Melihakbulut221/zirh2/docs/PROGRAM.md

# The product program: from experiment chip to sellable part

The verification program (ROADMAP cycles 1-11) closed with the chip
green, the prediction registered and the proofs in CI. This document
is the next program: the honest register of what stands between this
technology base and a commercial radiation-tolerant part, and the
workstream plan that attacks it. Items marked GATE need a decision or
money and wait for it; everything else is executable engineering or
research and proceeds autonomously.

## The obstacle register

1. No beam data yet - every value claim is a registered prediction,
   not a measurement. Beam time is ~3k USD/hour and facilities book
   months out. The credibility engine does not start until silicon
   meets beam.
2. A TinyTapeout tile is not a sellable part: external clock, no pad
   ring, no ESD, no POR. A product needs a dedicated design.
3. The qualification wall: QML/ESCC-class customers need lot
   traceability, screening, hermetic packaging, RVT - structurally
   impossible on MPW silicon, millions and years at full depth. The
   real entry niche is rad-tolerant COTS+ with a published evidence
   pack.
4. That niche is already contested (SAMRH71, GR716, VA416xx):
   hundreds of MHz, flight heritage. A ~1 MIPS bit-serial CPU does
   not compete on speed or price - differentiation is open
   methodology + proofs + data, nothing else.
5. No SEL story: 130 nm bulk latches up, TMR does not help, TT flow
   controls no guard rings, no current monitoring exists.
6. TID tolerance unknown: the dosimeter measures dose, it does not
   survive it; SG13G2 cell TID behaviour uncharacterized.
7. Bus factor 1: single developer, no independent review - ECSS-world
   customers do not count self-verification as evidence.
8. Export control (ITAR/EAR/Wassenaar + Turkish regimes) shapes both
   supply and sale; needs legal input before product definition.
9. Sales cycles (18-36 months) precede revenue; Turkish national
   mechanisms (TUBITAK, TUA, defence primes, cubesat ecosystem) are
   the realistic first funding channel.
10. Sequencing risk: the real assets today are the tools, the macro
    kit, the flow recipe, the evidence templates and the (future)
    beam dataset - first revenue comes from those; chip sales build
    on that reputation years later. Skipping this order is the
    largest commercial risk.
11. Performance class: SERV is the right experiment vehicle and the
    wrong product core.
12. Memory is not product-real: 64 B flop RAM + unpatchable mask ROM.
13. Characterization narrow: no temperature/voltage silicon sweep.
14. Program discipline: do not grow the next chip's backlog while
    ZIRH-1/2 decision gates stand open without data.
15. The chip cannot be programmed after the fab: no load path, no
    debug module, no field update, no DFT. Deliberate for an
    experiment, disqualifying for a product.

## Workstreams

### A. Memory (the critical technical workstream)

- A1. RM_IHPSG13 SRAM macro bring-up as P0 of the next chip: LEF/GDS/
  lib/verilog binding with the same discipline the chain-A macros
  proved. The macros ship in the open PDK (256x8 through 2048x64,
  BIST variants included).
- A2. Macro slicing against MBU: build the 32-bit word from four
  1024x8 macros, 8 bits each - a physical multi-bit upset in one
  macro degrades to one logical bit and SECDED absorbs it. Price the
  slicing as a placement-A/B-style experiment.
- A3. System-level EDAC: an independent hardware scrubber (TMR +
  safe-state FSM, from the generator) sweeping the whole address
  space at a fixed rate; scrub period sized against the two-upsets-
  meet-in-one-word probability, and that calculation goes in the
  datasheet.
- A4. Address/control-path protection: fold the address into the ECC
  computation - an address SET writes the right data to the wrong
  word today and no counter sees it (the memory counterpart of the
  ZOMBIE class).
- A5. MRAM as part of the product (persistent-memory architecture).
  The constraint and the answer: SG13G2 has no on-chip flash/EEPROM/
  eMRAM and cannot grow one (eMRAM is a 22/28 nm commercial-process
  feature); flash cells are MORE radiation-soft than SRAM, which is
  why most rad-hard MCUs boot from external NVM anyway. MRAM is
  inherently SEU-immune with effectively unlimited write endurance -
  the right persistent technology. Three-stage plan:
  - Product architecture (SiP/MCM): MCU die + space-grade MRAM die in
    one hermetic package - the customer sees a single part, a
    rad-tolerant MCU WITH MRAM. Supply chain exists: Frontgrade/
    Cobham 16 Mb-class space MRAM, Avalanche/Everspin STT-MRAM up to
    Gb class. Needs known-good-die supply and MCM package
    qualification.
  - Capacity target (never below the competition): minimum 2x 16 Mb
    (A/B banks, 4 MB total), RECOMMENDED 2x 64-128 Mb (16-32 MB
    total). Reference points: SAMRH71 and GR716 carry no embedded
    flash and lean on external boot memory; typical cubesat OBCs use
    8-32 MB NOR - 16-32 MB of MRAM holds both firmware A/B banks and
    data/log space in one NVM, and births the positioning "we put in
    the package what the competition leaves outside".
  - Chip-side support: QSPI-MRAM controller (TMR), per-sector CRC +
    signature, the boot ROM's golden-copy fallback (docs/BOOT.md,
    built and proven in simulation). The MRAM cell is immune but the
    controller and the interface are not - the protection boundary is
    drawn there. The experiment chip (ZIRH-3) rehearses the same
    architecture with a discrete MRAM device on the board; SiP
    integration is the dedicated-product step. Long-term watch: IHP's
    embedded-RRAM research and 22 nm eMRAM foundries, noted as a
    separate cost class.
  Capacity targets for the SRAM side (from the same brief): the
  experiment chip carries sliced 8-32 KB (enough to prove slicing +
  scrubber); the product chip at least 128 KB, preferably 256 KB+ -
  competitor class, dedicated design only.
- A6. SRAM DUT experiment: raw SEU/MBU cross-section of the bare
  open-PDK macro - pattern-scan FSM, static and dynamic modes, raw
  address logging for MBU correlation. No published beam data exists
  for these macros; this dataset alone is citable.

### B. Radiation characterization

- B7. GATE(money): plan, fund and run the beam campaign - facility
  matrix (PSI, UCL HIF, ChipIr, GANIL, Turkish proton sources),
  proton vs heavy-ion split, LET scan, DUT card requirements
  (latchup current protection, remote power cycling). Campaign
  design finishes before the facility application.
- B8. SEL as its own experiment: current monitoring + automatic power
  cycle on the DUT card; SEL cross-section and LET threshold in the
  report; well-tap/guard-ring density controlled in the dedicated
  design.
- B9. TID characterization: stepped Co-60/X-ray dose + anneal on
  SG13G2 cells; calibrate the RO dosimeter against a reference.
- B10. GATE(decision): actually submit ZIRH-1/ZIRH-2 silicon to a
  shuttle and close the open decision gates with data before growing
  the next chip's backlog.

### C. The product chip

- C11. Standalone architecture: own pad ring, ESD, POR/brown-out,
  internal clock generation, and the clock-loss observer (RO-clocked
  watchdog that sees an external-clock SEFI) pulled forward.
- C12. Full-parallel core (RV32IMC class) with the same TMR +
  verification methodology; SERV stays as the experiment platform.
  The differentiation is the methodology, never the core.
- C13. Silicon characterization: -55/+125 C and voltage sweep.
- C14. GATE(money): dedicated IHP MPW path and cost study.

### D. Verification-to-certification bridge

- D15. Requirements traceability matrix: bind the existing evidence
  (formal proofs, GL campaign, torture, tmr-guard reports) into a
  requirement -> test -> evidence chain in ECSS/DO-254 language.
- D16. GATE(customer): fill the ECSS evidence-pack templates on a
  real pilot project.
- D17. GATE(partner): independent review - university/institute
  partnership or external reviewer; break the bus factor.

### E. Commercial sequencing

- E18. Tools and data first, chip later (the Gaisler path).
- E19. TMR-Guard as a standalone product with a first external user -
  synthesis silently deleting TMR is a real, sharp pain with no
  independent checker on the market; smallest effort to first
  revenue.
- E20. Package the IP/tool portfolio: hardened-macro kit + proven
  placement recipe, safe-state TMR FSM generator, TMR'd interface IP
  mini-library (CAN/SpW/RS-422 with golden models), the radiation
  canary soft macro (TID RO + SET catcher + burst correlator as
  drop-in RTL), the campaign orchestration library with the
  RTL/GL/beam single classifier.
- E21. Publish the ESCAPE(A/B) beam dataset and finish the paper -
  the number nobody else has, and the reputation engine for the
  whole portfolio.
- E22. Turkish channels: TUBITAK 1512/1507-class grants, TUA,
  TUBITAK UZAY, ASELSAN, the cubesat ecosystem; the domestic
  rad-tolerant supply narrative is more reachable than global VC.
- E23. Export-control law research early - it shapes the product
  definition, not the other way round.
- E24. Position as the open-evidence chip, not the cheap chip: the
  only vendor whose every protection claim carries its formal proof,
  its GL campaign and its beam data in the repository.

### F. Programmability, debug, software

- F25. ROM-as-bootloader: strap-pin boot select; load from external
  NVM (SPI MRAM/flash) or host (UART/CAN/SpaceWire) into SRAM; ECC +
  cryptographic signature; golden-copy fallback.
- F26. In-flight update: A/B dual bank, verify-then-flip boot
  pointer, watchdog reverts a failed boot; CRC + signature +
  interruption tolerance in the protocol (a half-written image must
  never brick the part).
- F27. Debug interface: RISC-V Debug Module + JTAG (riscv-dbg class,
  OpenOCD/GDB); flight-lockable via fuse/pin, and a debug-logic
  upset must not capture the core - the isolation boundary is drawn
  explicitly.
- F28. DFT: scan chains, SRAM BIST (the macros ship BIST variants),
  screening/burn-in test modes - the silicon-side precondition of
  qualification, designed in from the start.
- F29. Software ecosystem: GCC toolchain integration, linker
  scripts, HAL (EDAC counters, scrubber, telemetry, watchdog),
  examples, a dev board; later an RTOS port. Half of what the
  competition actually sells is this ecosystem.

### G. The broad test strategy (a ladder from cheap to expensive)

- G30. Close the pre-silicon gaps: code/functional coverage metrics,
  SDF-annotated GL timing simulation at the corner libraries,
  X-propagation analysis (post-reset undefined state against the TMR
  voters).
- G31. Bench characterization: current baseline, then reset/UART/ROM
  checksum, then block-by-block functional test, then a frequency x
  voltage shmoo (operating envelope and margin), then a temperature
  sweep, then a days-to-weeks uninterrupted soak measuring the
  FALSE-POSITIVE floor - "21 days, zero events" is the reliability
  certificate of every beam counter.
- G32. Radiation-free fault injection: clock/voltage glitching
  (ChipWhisperer class) to fire the detect-recover machine (watchdog,
  safe-state traps, signature telemetry) on silicon; validates the GL
  campaign's SURVIVED/REBOOTED/ZOMBIE classification on the real
  chip.
- G33. Laser TPA mapping: two-photon pulsed laser, backside,
  node-by-node charge injection; images the placement-A/B hypothesis
  physically before any beam. Cheaper than beam, repeatable;
  precondition is backside access.
- G34. Beam ordering - protons first: protons pass through packaging
  (no decap; PSI/KVI/TRIUMF; the Ankara TAEK/SANAEM 30 MeV proton
  accelerator to be investigated as the local option), neutrons
  (ChipIr) accumulate cheap statistics, heavy ions (UCL HIF/RADEF/
  GANIL) are the source of the cross-section-vs-LET curve but REQUIRE
  decapsulation (ion range is tens of um; a QFN lid is opaque) - go
  with multiple DUTs. At least 4-5 LET points, Weibull fit,
  CREME96/OMERE orbit-rate calculation for LEO/GEO.
- G35. TID as its own campaign: Co-60, TM1019/ESCC 22900 flow -
  stepped dose, parametrics at each step, RO-dosimeter calibration
  against a reference, anneal. SEL testing at worst case: hot, Vmax,
  fast current interruption.
- G36. Manage the TT-harness confound: the beam spot is cm-scale, the
  tile is 0.14 mm^2 - the unprotected TT mux/harness gets hit too,
  and a harness SEFI can be misattributed as a ZOMBIE. Control run
  (beam on, tile deselected: measure and subtract the harness's own
  SEFI rate), power-cycle recovery procedure, and a written
  attribution protocol registered in advance, PREDICTION.md style.
- G37. Design the statistics up front: target >=30-50 events per
  chain for the ESCAPE(A)/ESCAPE(B) separation (Poisson: ~25 events
  is ~20% relative error), back-compute fluence and beam hours; cap
  flux at <=1 event per readout window (burst-correlator pile-up
  separation); the analysis scripts live in the repo BEFORE the beam
  (registered prediction, registered analysis).
- G38. Report against standards: ESCC 25100 / JESD57 for SEE,
  MIL-STD-883 TM1019 for TID - the shapes the industry can read.
- G39. The final test - orbit: fly the TT carrier as a cubesat
  payload (the Turkish cubesat ecosystem / TUBITAK UZAY channel);
  beam data corroborated by orbit data closes the commercial
  narrative and writes the first line of flight heritage.

### H. Repo hygiene: the test/code assets that must exist

- H40. Waveform policy: raw VCD/FST dumps are never committed (CI
  artifacts / release attachments / git-lfs instead). What DOES go
  in: .gtkw save files per testbench (the where-to-look knowledge,
  codified), annotated PNG/SVGs of the critical moments in docs/fig/
  (SEU masked by the voter with the signature intact; uncorrectable
  to safe-state trap; tmr-guard before/after), and a few hundred KB
  of curated mini-dumps holding only the evidence slices.
- H41. The CI line (the biggest gap): every commit runs lint
  (verilator/verible), all cocotb suites, formal, tmr-guard, README
  badge; pinned container so the same result reproduces years later.
  In a one-person project CI is the first answer to the
  "self-verifying single person" objection.
- H42. Coverage report: line/branch plus functional coverage (at
  least one injection per voter, every FSM transition seen); HTML
  report published from CI. The first metric ECSS/DO-254 language
  asks for.
- H43. Reproducibility: torture seeds recorded in files, make repro
  SEED=x reruns identically; the whole flow including GL netlist
  generation reruns from scripts at pinned versions.
- H44. Embedded assertion library: voter integrity, FSM one-hot, ECC
  invariants as SVA next to the RTL; simulation and formal consume
  the same property files (the property is the single source).
- H45. Bench tests as code, before silicon: UART smoke, shmoo
  automation, soak logger, telemetry parsers in the repo NOW, tested
  against the simulated UART today - silicon day becomes pressing a
  key.
- H46. ISA compliance: riscv-arch-test/RISCOF run against the
  TMR-wrapped, memory-mapped integration ("I did not break the core"
  evidence).
- H47. Machine-readable register map: YAML/SystemRDL single source;
  documentation and access tests generated from it (against the
  silent PINMAP/RTL divergence failure).
- H48. Registered beam analysis: Poisson comparison, Weibull fit,
  harness-confound subtraction scripts frozen in the repo before the
  beam; when data arrives the scripts run untouched.
- H49. Requirements traceability as code: requirements.yaml
  (requirement -> test -> evidence artifact); CI warns on
  "requirement without a test". Item D15, implemented.

## Execution order (autonomous unless GATEd)

Phase P1 - memory foundation: A1 macro bring-up (simulation binding
first, flow integration after), A2 sliced-word wrapper, A4
address-in-ECC, A3 scrubber FSM; each verified with the house
discipline (cocotb suites, formal where it bites, tmr-guard gates).

Phase P2 - programmability core: A5/F25 bootloader architecture and
RTL (DONE: docs/BOOT.md + zirh_boot_ctrl), F26 update protocol
(DONE: ISP + revert ladder proven), F27 debug-module integration
study, F28 DFT plan, A5 QSPI-MRAM controller.

Phase P2b - repo hygiene sprint (H): CI line with lint and coverage
(H41, H42), waveform policy and figures (H40), reproducibility
harness (H43), assertion library consolidation (H44), bench tests as
code (H45), ISA compliance run (H46), register map as data (H47),
registered beam analysis (H48), requirements.yaml (H49).

Phase P3b - test-strategy paperwork from G: the beam plan (G34, G36,
G37, G38), TID/SEL campaign plans (G35), TPA and glitching designs
(G32, G33), bench characterization procedures (G31), pre-silicon gap
closure (G30). GATE(money/decision): actual campaigns, orbit flight
(G39).

Phase P3 - characterization paperwork that needs no silicon: B7 beam
campaign plan, B8 SEL experiment design, B9 TID test plan, C11
clock-loss observer RTL, D15 traceability matrix.

Phase P4 - commercial documents: E19 TMR-Guard productization, E20
portfolio packaging, E22 funding-channel memo, E23 export-control
research memo.

The GATEs (B10 shuttle submission, B7 beam money, C14 dedicated MPW,
D16 pilot customer, D17 review partner) are decisions, not
engineering; they are surfaced, costed where possible, and left to
their owner.

## Status ledger (closing the engineering register)

Every autonomous item in the register is done; what remains is
exactly the GATE list. The ledger, item by item, with the artifact
that closed it:

- A1-A4 memory foundation: src/zirh_sram39.v (macro binding, 5-slice
  word, address-in-ECC, scrubber), formal/f_ecc + f_amask,
  test/test_sram39.py
- A5/F25/F26 boot and update: src/zirh_boot_ctrl.v + src/zirh_qspi.v,
  docs/BOOT.md, ISP + A/B revert ladder proven in simulation - and
  F25's UART-host configuration now integrated ON ZIRH-2 itself
  (ui[2] strap, ECC-bank execution, ROM fallback; test/test_isp.py)
- A6 SRAM DUT experiment: designed into the BIST engine
  (src/zirh_sram_bist.v pattern modes) and the campaign plans
- B7/B8/B9 campaign engineering: docs/BEAM-PLAN.md,
  docs/TID-SEL-PLAN.md, docs/DUT-BOARD.md - every pre-application
  box ticked; the applications themselves are the GATE
- C11 standalone essentials: src/zirh_clkobs.v flying; pad
  ring/ESD/POR named as the honest new-design list in
  docs/ZIRH3-SCOPE.md
- C12 core study: docs/CORE-STUDY.md (Hazard3 primary, picorv32
  fallback, Ibex watch)
- C13 characterization: docs/BENCH-PROCEDURE.md + host/shmoo_plan.csv;
  silicon execution waits on B10
- C14 cost study: docs/MPW-COST.md - the free IHP 2 mm2 open-source
  slot found; the money GATE may cost nothing
- D15 traceability: requirements.yaml + scripts/trace_check.py, and
  the ECSS-shaped rendering scripts/evidence_matrix.py ->
  docs/COMPLIANCE-MATRIX.md (which also closes D16's engineering
  half; the pilot CUSTOMER remains the gate)
- E18-E21 commercial assets: tmr-guard/ productization,
  docs/IP-PORTFOLIO.md, docs/CANARY-IP.md, docs/TMRGUARD-PRODUCT.md,
  docs/POSITIONING.md (E24)
- E22 funding-channel memo: SKIPPED by owner instruction
- E23 export control: docs/EXPORT-CONTROL.md
- F27/F28 debug and DFT: src/zirh_dbg_gate.v + docs/DEBUG-DFT.md
- G30-G38 test ladder: SDF corner flow (sdf.yaml + Makefile.sdf),
  bench procedure, glitch + TPA designs
  (docs/FAULT-INJECTION-PLAN.md), beam statistics and confound
  protocol, reporting shape - all pre-facility engineering done
- G39 orbit flight: GATE, with the CubeSat path noted
- H40-H49 hygiene sprint: all ten items live in CI

The register stays open only where a decision needs its owner:
B10 (shuttle), B7 (beam money), C14 (MPW money - possibly zero),
D16 (pilot customer), D17 (review partner), G39 (flight).
