Melihakbulut221/zirh2/docs/COMPLIANCE-MATRIX.md

# ZIRH-2 compliance matrix (ECSS-shaped pilot)

GENERATED by scripts/evidence_matrix.py from requirements.yaml - the D16 pilot: the evidence-pack shape filled from a real project's requirements, every row citing an artifact that runs in CI today. Verification method is inferred from where each requirement's evidence lives. Regenerated and diffed in CI, so the matrix cannot drift from the requirements the build already gates.

**29 requirements** across 7 verification-method classes:

- Test: 12
- Formal Proof + Test: 5
- Analysis/Tool: 3
- Test + Analysis/Tool: 3
- Analysis/Tool + Review/Inspection: 2
- Review/Inspection: 2
- Test + Review/Inspection: 2

| ID | Requirement | Method | Verification artifacts | Evidence location |
|---|---|---|---|---|
| R1 | A single upset in any one TMR replica shall never reach a voted output, in any cycle, at silicon timings. | Formal Proof + Test | `formal/f_ring.sv`<br>`test/test_gl_seu_sweep.py` | formal.yaml formal job (BMC + k-induction, N=4/8/32); gds.yaml gl_test (384 exhaustive singles on the shipped netlist) |
| R2 | An escape shall require the same bit upset in two replicas within one clock cycle, and no other fault geome... | Formal Proof + Test | `formal/f_ring.sv`<br>`test/test_gl_seu_sweep.py` | formal cover witness (docs/fig/escape_witness.png); pair geometry sweep in gl_test; registered in docs/PREDICTION.md |
| R3 | The SECDED memory shall correct every single stored-bit error at all 39 positions, detect every double, and... | Formal Proof + Test | `formal/f_ecc.sv`<br>`test/test_sram39.py` | formal.yaml (exhaustive BMC over words, faults, initial states); ci.yaml units job on the macro-backed storage |
| R4 | A wrong-row read - any single-bit address corruption at the memory boundary - shall decode as uncorrectable... | Formal Proof + Test | `formal/f_amask.sv`<br>`test/test_sram39.py` | formal.yaml (all words x all fold-distinct row pairs); wrong-row detection case in the sram39 suite |
| R5 | The background scrubber shall repair a corrupted word no firmware access ever touches, within one sweep per... | Test | `test/test_sram39.py` | ci.yaml units job (scrubber heal case; micro-interleave behaviour proven during the Cycle-12 ghost hunt) |
| R6 | An interrupted or corrupted firmware load shall never produce a bootable-looking bank; the no-brick propert... | Test | `test/test_boot.py` | ci.yaml units job (half-load and bad-CRC cases; valid flag flips only on stored-image read-back CRC) |
| R7 | A firmware that fails to sign on shall be reverted automatically - other valid bank first, golden ROM last ... | Test | `test/test_boot.py` | ci.yaml units job (watchdog revert ladder case) |
| R8 | The debug domain shall be lockable for flight such that no debug-side activity or upset reaches the core or... | Formal Proof + Test | `formal/f_dbg.sv`<br>`test/test_dbg_gate.py` | formal.yaml (inertness + absorbing-verdict induction); ci.yaml units job (hammering, strap-wiggle, passthrough) |
| R9 | The SRAM march self-test shall detect a disturbed cell at its exact address and slice, and the beam scan mo... | Test | `test/test_bist.py` | ci.yaml units job (march clean, disturb-detect-preserve, rescreen clean) |
| R10 | Every TMR structure shall survive synthesis with its replicas and voters intact; collapse shall fail the bu... | Analysis/Tool | `scripts/check_tmr.sh`<br>`tmr-guard/tmr_guard.py` | ci.yaml tmr-guard job (replica and flop counts pinned in both directions; the product tool runs its flagship manifest... |
| R11 | The computer's liveness and death shall be separable from the instrument's at the pins, and a computer deat... | Test | `test/test.py`<br>`test/test_gl_campaign.py` | test.yaml (frame/signature/watchdog cases); gds.yaml gl_test campaign contract (SURVIVED/REBOOTED/ZOMBIE, silence for... |
| R12 | The processor integration - pipelined fetch, ROM data port, bus, ECC RAM - shall execute random RV32I progr... | Test + Analysis/Tool | `scripts/torture_gen.py`<br>`scripts/torture.sh`<br>`test/test_torture.py` | formal.yaml torture job (30 programs, daily seed, seed printed for replay; 100/100 on the recorded seeds) |
| R13 | The ZIRH-authored RTL shall lint clean under the armed warning set; waivers shall be few and individually j... | Analysis/Tool | `scripts/lint.sh` | ci.yaml lint job |
| R14 | The pre-beam prediction and its analysis shall be frozen in the repository before any beam exposure; beam d... | Analysis/Tool | `scripts/seu_predict.py` | docs/PREDICTION.md (git history is the registration timestamp); G48 registered-analysis scripts are the successor ite... |
| R15 | Every interface experiment - CAN, SpaceWire, RS-422 framing and the CPU-untouchable telemetry mirror - shal... | Test | `test/test_can.py`<br>`test/test_spw.py`<br>`test/test_rs422.py`<br>`test/test_mirror.py`<br>`test/test_uart_regs.py` | test.yaml unit runs (protocol FSMs, loopback, flood atomicity) |
| R16 | The TMR register library shall heal any single-replica flip through voted feedback and report the mismatch,... | Test | `test/test_tmr.py`<br>`test/test_tmrflip.py` | test.yaml unit runs (per-width flip sweeps, err pulse checks) |
| R17 | Under sustained random stress - command fuzzing, flip storms, marathon soak, reboot storms - the chip shall... | Test | `test/test_fuzz.py`<br>`test/test_storm.py`<br>`test/test_mega.py`<br>`test/test_campaign.py` | test.yaml marathon runs; host/zirh_campaign.py contract; 30-trial x 2-seed campaign records in docs/SCOPE.md |
| R18 | Every block shall hold its unit contract in isolation - reset and clocking, bus slave protocol, ECC RAM sem... | Test | `test/test_clk_rst.py`<br>`test/test_bus.py`<br>`test/test_ecc_ram.py`<br>`test/test_env.py`<br>`test/test_hk.py`<br>`test/test_rom.py`<br>`test/test_soc.py`<br>`test/test_tlm2.py`<br>`test/test_z2.py` | test.yaml and ci.yaml unit runs |
| R19 | The open-PDK SRAM macro behavioral model shall be bound and exercised - write, synchronous read, bit-mask m... | Test | `test/test_sram_smoke.py` | ci.yaml units job (bare macro smoke) |
| R20 | The register map shall have one machine-readable source; documentation and firmware headers shall be genera... | Analysis/Tool + Review/Inspection | `regmap.yaml`<br>`scripts/regmap_gen.py` | ci.yaml trace job (regmap sync gate + fw/zirh.h address cross-check) |
| R21 | The bench bring-up ladder - smoke, soak with a measured false-positive floor, shmoo envelope mapping - shal... | Analysis/Tool + Review/Inspection | `host/zirh_bench.py`<br>`scripts/beam_analysis.py` | ci.yaml trace job selftests (mock chip: smoke passes, broken sequence caught, quiet soak floor is zero) |
| R22 | The integrated core shall pass the riscv-arch-test rv32i suite with signatures identical to the shipped ref... | Test + Analysis/Tool | `test/arch/tb_arch.v`<br>`scripts/archtest.sh` | arch.yaml (38/38 signatures matched against riscv-arch-test 2.7.4 references) |
| R23 | Every product-program FSM arc shall be exercised by the unit suites; an undriven arc or an unmapped transit... | Test + Analysis/Tool | `test/fsm_cov.py`<br>`scripts/coverage_report.py` | ci.yaml units job coverage gate (26/26 arcs, POR arcs classified) |
| R24 | Module self-invariants shall be stated once and consumed by both simulation (fatal on violation) and formal... | Review/Inspection | `src/zirh_assert.vh` | unit suites with -DZIRH_ASSERTIONS armed; formal.sh proofs compile the same macros under -DFORMAL |
| R25 | The QSPI-MRAM controller shall stream stored bytes exactly, in both single and quad widths, freeze the cloc... | Test + Review/Inspection | `src/zirh_qspi.v`<br>`test/test_qspi.py` | ci.yaml units job (x1, stalled x1, x4, abort, and the full boot-from-MRAM into the SECDED SRAM) |
| R26 | An independent-clock observer shall detect the death of the external clock, report it as a sticky event wit... | Test + Review/Inspection | `src/zirh_clkobs.v`<br>`test/test_clkobs.py` | ci.yaml units job (hand-driven main clock killed and resurrected twice; detection, sticky semantics and the count all... |
| R27 | The firmware driver layer shall be generated-map-true: every HAL access resolves against addresses generate... | Review/Inspection | `fw/hal/zirh_hal.h`<br>`fw/hal/example_app.c` | fw.yaml HAL compile gate; ci.yaml regmap sync gate guarantees the addresses cannot drift from the RTL |
| R28 | The shipped netlist shall boot and speak at the spec clock with the hardening run's own corner delays annot... | Test | `test/test_sdf.py`<br>`test/sdf_load.v` | sdf.yaml three-corner matrix per hardening release; the SDF-support micro-experiment recorded in ROADMAP Cycle 26 |
| R29 | The chip shall accept a CRC32-sealed firmware image over UART when strapped for ISP, verify the STORED imag... | Test | `test/test_isp.py`<br>`test/sv/zirh_boot_scenarios_tb.sv` | test.yaml (cocotb suite; commit, corrupt-CRC refusal, bad-magic refusal, ROM fallback sign-on) and the boot-controlle... |

## Reviewer notes

This matrix is the ECSS-Q-ST-60/DO-254-shaped view of the same requirements the build enforces via scripts/trace_check.py (no requirement without a test) and scripts/regmap_gen.py (no map drift). The formal rows are machine-checked theorems; the test rows run in the ci/test/formal/arch workflows on every push; the tool rows (tmr-guard, coverage, beam analysis) carry their own negative controls. The gap this pilot closes: a template proves nothing, a filled matrix that regenerates from the gated source proves the evidence chain is real and current.
