Melihakbulut221/zirh2/docs/ZIRH3-SCOPE.md

# ZIRH-3 scope: the dedicated die, gated by data

The program has, in simulation, built every piece a dedicated
radiation-tolerant SoC needs: SECDED SRAM with slicing, scrubber and
address protection; a QSPI-MRAM boot path; a debug isolation gate; a
BIST engine; a clock-loss observer. ZIRH-3 is where they become one
die. This document is its scope - and, as importantly, its GATE: the
program's own measure-before-believing rule applies to ZIRH-3 itself.

## The gate comes first (B10, obstacle 14)

ZIRH-3 does NOT start because the blocks are ready. It starts when
ZIRH-1 and ZIRH-2 silicon has produced beam data that closes the open
decision gates - because a dedicated die that bakes in an unverified
placement-A/B assumption would be the one time this program believed
before it measured. The blocks below are DESIGN-READY, not
tape-out-authorized. Building them in simulation now is correct;
committing them to silicon waits for the gate. This document exists
so that when the gate opens, integration is assembly, not invention.

## Vehicle (from docs/MPW-COST.md)

The free IHP OpenMPW ~2 mm2 open-source slot is the ZIRH-3 vehicle:
a real dedicated die - own padframe, own POR, controlled guard-ring
and well-tap density - at zero fabrication cost, on exactly this
repository's open flow and license. The dedicated-design rehearsal
therefore waits behind THIS data gate, not behind money.

## Integration map (all blocks exist in src/ today)

```
  pad ring + ESD + POR/brown-out        [NEW: product-chip essentials,
       |                                 obstacle 2 - the one genuinely
       v                                 new design area]
  clk_rst + zirh_clkobs  <-- RO clock   [clock-loss observer, Cycle 23]
       |
  SERV (or the C12 core when it lands)   [SERV first: the methodology
       |  ibus/dbus                       carries; core swap is later]
  +----+--------------------------------+
  |  zirh_boot_ctrl  <-- zirh_qspi <-- MRAM (on-board discrete)
  |       | commits into                 [A5 boot path, Cycles 22/13]
  |  zirh_sram39 (sliced SECDED + scrubber + BIST)
  |       |                              [Cycles 11/12/15]
  |  zirh_dbg_gate  <-- riscv-dbg (F27)   [debug isolation, Cycle 14]
  +-------------------------------------+
  housekeeping + env (radiation canary) + interfaces + telemetry
       |                                 [all shipping on ZIRH-2]
  the placement-A/B experiment, carried forward for the DEDICATED
  layout where guard rings and separation are OURS to control
```

## What is genuinely new (the honest new-design list)

Everything above except three items is proven in simulation on
ZIRH-2 or built and unit-tested this program. The genuinely new
silicon design, the part that needs the most review, is small and
named:

1. **Pad ring, ESD, POR/brown-out** - obstacle 2's essentials, the
   TT harness provided these and a dedicated die must not.
2. **The RO clock source for the observer** - zirh_clkobs takes an
   independent clock as input; on a dedicated die that clock is a
   hand-instantiated ring (the zirh_env_ro discipline), which needs
   its own bring-up.
3. **SRAM macro hardening at the dedicated floorplan** - the macros
   are proven in behavioral simulation; their PHYSICAL integration
   (PDN to the two-TopMetal stack, guard rings, the GDS-merge
   snags MPW-COST notes) is real flow work.

Everything else is instantiation of verified blocks.

## Scope discipline

Not in ZIRH-3: the C12 full-parallel core (SERV carries the
methodology; the core swap is a later, separable step), the SiP MRAM
integration (a discrete on-board MRAM rehearses the architecture
first), and anything that would grow the die past the free 2 mm2
without a measured reason to. The program's rule holds at the die
level too: add silicon only when data justifies it.
