Melihakbulut221/zirh2/docs/fig/seu_voter_mask.png

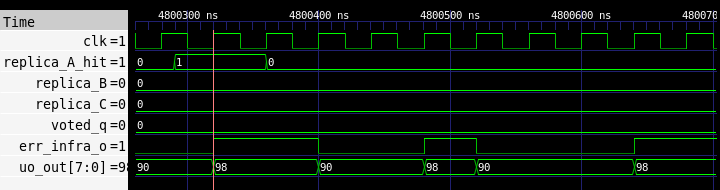
docs/fig/seu_voter_mask.png
