Melihakbulut221/zirh2/docs/fig/uncorrectable_detect.png

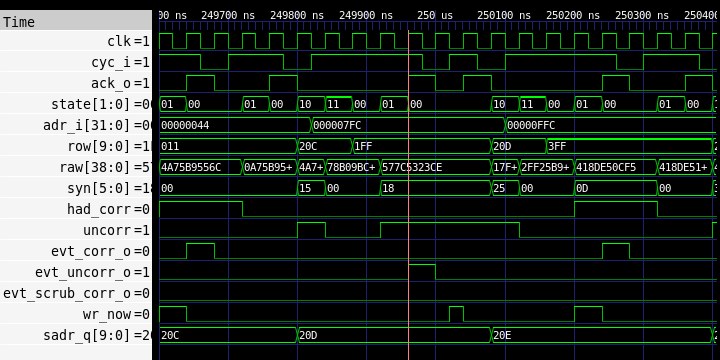
docs/fig/uncorrectable_detect.png
