Melihakbulut221/zirh2/host/zirh_ground.py

#!/usr/bin/env python3
# =============================================================================
# ZIRH - ground station: telemetry stream decoder
#
#   python3 host/zirh_ground.py --port /dev/ttyUSB0            live capture
#   python3 host/zirh_ground.py --file capture.bin             offline decode
#   python3 host/zirh_ground.py --selftest                     no hardware
#
# Decodes the 10-byte telemetry frames the chip emits unprompted:
#
#   0  0x5A 'Z'    1  0x52 'R'
#   2  STATUS      {seq[3:0], armed, infra, mode[1:0]}
#   3-4 PLAIN  5-6 RAW  7-8 ESCAPE   (16-bit big-endian)
#   9  XOR of bytes 0..8
#
# The line also carries echo bytes between frames, so the decoder treats the
# input as an untrusted byte stream: it hunts for the sync pair, validates
# the checksum before accepting a frame, and resynchronizes by advancing one
# byte on any mismatch. Bytes that never validate are reported as non-frame
# traffic (echo or line noise).
#
# Per frame it reports counter values and deltas; it flags sequence gaps
# (dropped frames), checksum failures, infra events and counter drops
# (a counter going backwards without CLEAR means instrument trouble).
# Optional CSV log for beam-campaign records.
#
# Requires: Python 3.8+. pyserial only for --port mode.
# =============================================================================

import argparse
import json
import sys
import time

SYNC0 = 0x5A
SYNC1_V1, SYNC1_V2, SYNC1_V21 = 0x52, 0x32, 0x33
FRAME_LENS = {SYNC1_V1: 10, SYNC1_V2: 17, SYNC1_V21: 20}   # 'R','2','3'
MODES = {0: "zeros", 1: "ones", 2: "checker", 3: "checker"}


class Frame:
    __slots__ = ("ver", "seq", "armed", "infra", "mode", "plain", "raw",
                 "escape", "raw_b", "esc_b", "ecc_c", "ecc_u", "cpu_sig",
                 "boot", "bus_to", "ferr")

    def __init__(self, buf):
        self.ver = {SYNC1_V1: 1, SYNC1_V2: 2, SYNC1_V21: 21}[buf[1]]
        status = buf[2]
        self.seq = (status >> 4) & 0xF
        self.armed = (status >> 3) & 1
        self.infra = (status >> 2) & 1
        self.mode = status & 3
        self.plain = (buf[3] << 8) | buf[4]
        self.raw = (buf[5] << 8) | buf[6]      # v2: RAW_A
        self.escape = (buf[7] << 8) | buf[8]   # v2: ESC_A
        self.boot = self.bus_to = self.ferr = None
        if self.ver >= 2:
            self.raw_b = (buf[9] << 8) | buf[10]
            self.esc_b = (buf[11] << 8) | buf[12]
            self.ecc_c, self.ecc_u, self.cpu_sig = buf[13], buf[14], buf[15]
        else:
            self.raw_b = self.esc_b = None
            self.ecc_c = self.ecc_u = self.cpu_sig = None
        if self.ver == 21:
            self.boot, self.bus_to, self.ferr = buf[16], buf[17], buf[18]


def checksum_ok(buf):
    chk = 0
    for b in buf[:-1]:
        chk ^= b
    return chk == buf[-1]


class Decoder:
    """Feed bytes in, get (event, payload) tuples out.

    Events: ("frame", Frame), ("skip", byte)  - byte that is not part of any
    valid frame (echo traffic or noise), ("chk_fail", bytes) - sync pair with
    a bad checksum (counted, first byte re-emitted as skip during resync).
    """

    def __init__(self):
        self.buf = bytearray()

    def feed(self, data):
        self.buf.extend(data)
        out = []
        while True:
            # drop leading bytes that cannot start a frame
            while self.buf and self.buf[0] != SYNC0:
                out.append(("skip", self.buf.pop(0)))
            if len(self.buf) >= 2 and self.buf[1] not in FRAME_LENS:
                out.append(("skip", self.buf.pop(0)))
                continue
            if len(self.buf) < 2:
                return out
            flen = FRAME_LENS[self.buf[1]]
            if len(self.buf) < flen:
                return out
            cand = bytes(self.buf[:flen])
            if checksum_ok(cand):
                out.append(("frame", Frame(cand)))
                del self.buf[:flen]
            else:
                out.append(("chk_fail", cand))
                out.append(("skip", self.buf.pop(0)))  # resync one byte on


class Session:
    """Tracks continuity across frames and renders report lines."""

    BEAM_FIELDS = ("plain", "raw", "escape", "raw_b", "esc_b",
                   "ecc_c", "ecc_u", "boot", "bus_to", "ferr")

    def __init__(self, csv=None):
        self.prev = None
        self.frames = 0
        self.gaps = 0
        self.chk_fails = 0
        self.skipped = 0
        self.totals = {f: 0 for f in self.BEAM_FIELDS}
        self.csv = csv
        if csv:
            csv.write("time,seq,armed,infra,mode,plain,raw,escape,"
                      "d_plain,d_raw,d_escape,gap\n")

    def _delta(self, now, before):
        d = now - before
        return d if d >= 0 else None  # negative without CLEAR: suspicious

    def _accumulate(self, fr):
        """Positive counter deltas summed per channel; a clear (counter
        going backward) contributes nothing. This is the yield ledger the
        cross-section math consumes."""
        if self.prev is None or self.prev.ver != fr.ver:
            return
        for f in self.BEAM_FIELDS:
            now, before = getattr(fr, f), getattr(self.prev, f)
            if now is None or before is None:
                continue
            d = now - before
            if d > 0:
                self.totals[f] += d

    def report_dict(self, fluence_cm2=0.0, meta=None):
        """Per-channel totals and, when a real fluence is given, the
        per-channel cross-sections - the number a beam shift exists to
        produce. JESD57A-shaped metadata rides along."""
        rep = {"frames": self.frames, "gaps": self.gaps,
               "chk_fails": self.chk_fails, "junk_bytes": self.skipped,
               "event_totals": dict(self.totals)}
        if meta:
            rep.update(meta)
        if fluence_cm2 > 0:
            rep["fluence_cm2"] = fluence_cm2
            rep["cross_section_cm2"] = {
                f: n / fluence_cm2 for f, n in self.totals.items() if n}
        return rep

    def handle(self, event, payload, quiet_skips=True):
        lines = []
        if event == "skip":
            self.skipped += 1
            if not quiet_skips:
                lines.append(f"  echo/noise byte: {payload:#04x}")
        elif event == "chk_fail":
            self.chk_fails += 1
            lines.append("! checksum FAIL: " + payload.hex(" "))
        elif event == "frame":
            f = payload
            self.frames += 1
            gap = 0
            d = ("-", "-", "-")
            if self.prev is not None:
                gap = (f.seq - self.prev.seq - 1) % 16
                if gap:
                    self.gaps += gap
                dp = self._delta(f.plain, self.prev.plain)
                dr = self._delta(f.raw, self.prev.raw)
                de = self._delta(f.escape, self.prev.escape)
                d = tuple("RESET?" if x is None else f"+{x}" for x in (dp, dr, de))
            flags = "".join([
                "A" if f.armed else "-",
                "I" if f.infra else "-",
            ])
            extra = ""
            if f.ver >= 2:
                extra = (f"  RAW_B={f.raw_b:5d} ESC_B={f.esc_b:5d} "
                         f"ECC={f.ecc_c}/{f.ecc_u} SIG={f.cpu_sig:02x}")
            if f.ver == 21:
                extra += f" BOOT={f.boot} BUSTO={f.bus_to} FERR={f.ferr}"
                if self.prev is not None and self.prev.boot is not None \
                        and f.boot > self.prev.boot:
                    extra += "  ! CPU REBOOTED (watchdog)"
            lines.append(
                f"v{f.ver} seq={f.seq:2d} [{flags}] mode={MODES[f.mode]:7s} "
                f"PLAIN={f.plain:5d} ({d[0]:>6s})  "
                f"RAW={f.raw:5d} ({d[1]:>6s})  "
                f"ESCAPE={f.escape:5d} ({d[2]:>6s})" + extra
                + (f"  ! {gap} frame(s) LOST" if gap else ""))
            if self.csv:
                self.csv.write(
                    f"{time.time():.3f},{f.seq},{f.armed},{f.infra},"
                    f"{MODES[f.mode]},{f.plain},{f.raw},{f.escape},"
                    f"{d[0]},{d[1]},{d[2]},{gap}\n")
            self._accumulate(f)
            self.prev = f
        return lines

    def summary(self):
        return (f"frames={self.frames}  lost={self.gaps}  "
                f"checksum_fails={self.chk_fails}  other_bytes={self.skipped}")


def make_frame(seq, plain, raw, escape, armed=1, infra=0, mode=0, corrupt=False):
    status = ((seq & 0xF) << 4) | (armed << 3) | (infra << 2) | mode
    buf = bytearray([SYNC0, SYNC1_V1, status,
                     plain >> 8, plain & 0xFF,
                     raw >> 8, raw & 0xFF,
                     escape >> 8, escape & 0xFF])
    chk = 0
    for b in buf:
        chk ^= b
    buf.append(chk ^ (0x01 if corrupt else 0x00))
    return bytes(buf)


def make_frame2(seq, cpu_sig, esc_a=0, esc_b=0, corrupt=False):
    status = ((seq & 0xF) << 4) | (1 << 3)
    buf = bytearray([SYNC0, SYNC1_V2, status, 0, 0, 0, 0,
                     esc_a >> 8, esc_a & 0xFF, 0, 0,
                     esc_b >> 8, esc_b & 0xFF, 0, 0, cpu_sig])
    chk = 0
    for b in buf:
        chk ^= b
    buf.append(chk ^ (0x01 if corrupt else 0x00))
    return bytes(buf)


def make_frame21(seq, cpu_sig, boot=0, esc_a=0, esc_b=0, corrupt=False):
    status = ((seq & 0xF) << 4) | (1 << 3)
    buf = bytearray([SYNC0, SYNC1_V21, status, 0, 0, 0, 0,
                     esc_a >> 8, esc_a & 0xFF, 0, 0,
                     esc_b >> 8, esc_b & 0xFF, 0, 0, cpu_sig, boot, 0, 0])
    chk = 0
    for b in buf:
        chk ^= b
    buf.append(chk ^ (0x01 if corrupt else 0x00))
    return bytes(buf)


CAMPAIGN = [
    # (command byte, field checked, expected delta)
    (b"1", "raw", 1), (b"2", "escape", 1), (b"3", "raw_b", 1),
    (b"4", "esc_b", 1), (b"0", "plain", 1),
]


def campaign(sp, sess, dec, pump):
    """Bench fault-injection campaign: fire every injection path over the
    UART command set and verify exactly the right counter moves by one in
    the following frames. Requires --port."""
    import time as _t

    def next_frame(timeout=10.0):
        end = _t.time() + timeout
        got = []
        def sink(ev, pl):
            if ev == "frame":
                got.append(pl)
        while _t.time() < end and not got:
            data = sp.read(256)
            for ev, pl in dec.feed(data):
                sess.handle(ev, pl)
                sink(ev, pl)
        if not got:
            raise RuntimeError("no frame within timeout")
        return got[-1]

    sp.write(b"C")
    base = next_frame()
    print(f"campaign baseline: seq={base.seq}")
    failures = 0
    for cmd, field, delta in CAMPAIGN:
        before = getattr(next_frame(), field)
        sp.write(cmd)
        _t.sleep(0.05)
        after = getattr(next_frame(), field)
        ok = (after - before) == delta
        print(f"  cmd {cmd.decode()}: {field} {before}->{after} "
              f"{'ok' if ok else 'FAIL'}")
        failures += not ok
    sp.write(b"R")

    # environment monitor probes: raw byte answers, not frame fields, so
    # scan the incoming stream directly (the decoder resyncs afterwards)
    def scan_for(pred, timeout=5.0):
        end = _t.time() + timeout
        tail = []
        while _t.time() < end:
            for byte in sp.read(64):
                tail.append(byte)
                tail = tail[-16:]
                if pred(tail):
                    return tail
        return None

    env_fail = 0
    sp.write(b"E")
    if scan_for(lambda t: t[-1] == ord("e")) is None:
        print("  cmd E: no self-test ack FAIL")
        env_fail += 1
    sp.write(b"S")
    t = scan_for(lambda t: 0 < t[-1] < 0x20)
    print(f"  cmd S: set count {t[-1] if t else '?'} "
          f"{'ok' if t else 'FAIL (self-test must have counted)'}")
    env_fail += t is None
    sp.write(b"T")
    t = scan_for(lambda t: len(t) >= 2 and (t[-2] << 8 | t[-1]) > 256)
    if t:
        print(f"  cmd T: oscillator window {(t[-2] << 8 | t[-1])} counts")
    else:
        print("  cmd T: no window count FAIL")
        env_fail += 1

    # interface probes: CAN beacon must self-ack on a looped bench, the
    # SpaceWire link must reach Run (state 5) with the char round-tripped
    sp.write(b"k")
    if scan_for(lambda t: t[-1] == ord("b")) is None:
        print("  cmd k: no beacon ack FAIL")
        env_fail += 1
    sp.write(b"K")
    t = scan_for(lambda t: 0 < t[-1] < 0x20)
    print(f"  cmd K: CAN rx_ok {t[-1] if t else '?'} "
          f"{'ok' if t else 'FAIL (loop the CAN pins?)'}")
    env_fail += t is None
    sp.write(b"w")
    if scan_for(lambda t: t[-1] == ord("y")) is None:
        print("  cmd w: no link ack FAIL")
        env_fail += 1
    sp.write(b"W")
    t = scan_for(lambda t: t[-1] == 5)
    print(f"  cmd W: SpW state {'Run ok' if t else 'FAIL (loop the SpW pins?)'}")
    env_fail += t is None

    failures += env_fail
    total = len(CAMPAIGN) + 7
    print(f"campaign: {total - failures}/{total} paths ok")
    return failures == 0


def crosscheck(primary, mirror):
    """The dual-voice verdict. The mirror carries ONLY frames by
    construction, so junk there means a decoder or wiring problem; a
    primary drowning in junk while the mirror stays whole is the
    measured UART-flood signature - the exact failure the mirror pin
    exists to survive."""
    return {
        "primary_frames": primary.frames,
        "mirror_frames": mirror.frames,
        "primary_junk": primary.skipped,
        "mirror_junk": mirror.skipped,
        "mirror_clean": mirror.skipped == 0 and mirror.chk_fails == 0,
        "flood_suspected": (primary.skipped > 10 * max(1, primary.frames)
                            and mirror.frames > primary.frames),
    }


def crosscheck_line(primary, mirror):
    c = crosscheck(primary, mirror)
    verdict = ("FLOOD SUSPECTED - primary drowned, mirror carried the run"
               if c["flood_suspected"] else
               "dual voice consistent" if c["mirror_clean"] else
               "MIRROR DEGRADED - check wiring/baud")
    return (f"dual-voice: primary {c['primary_frames']} frames / "
            f"{c['primary_junk']} junk, mirror {c['mirror_frames']} frames / "
            f"{c['mirror_junk']} junk -> {verdict}")


def selftest():
    """Decoder must survive a hostile stream: echo bytes (including fake sync
    bytes), a corrupted frame, dropped frames, split feeds."""
    stream = (
        b"hello"                                   # echo traffic
        + make_frame(1, 0, 0, 0)
        + bytes([0x5A])                            # lone fake sync byte
        + make_frame(2, 3, 1, 0)
        + make_frame(3, 3, 1, 0, corrupt=True)     # checksum failure
        + bytes([0x5A, 0x52])                      # sync pair, then nothing valid
        + b"x"
        + make_frame(6, 4, 1, 0, infra=1)          # seq jump
        + make_frame2(7, 0xBE, esc_a=0, esc_b=2)   # a v2 frame in the same stream
        + make_frame2(8, 0xE1, corrupt=True)       # corrupted v2
        + make_frame2(9, 0x11)
        + make_frame21(10, 0x22, boot=1)           # v2.1 with a reboot count
        + make_frame21(11, 0x33, boot=2)           # BOOT climbed: reboot flagged
    )

    sess = Session()
    dec = Decoder()
    # feed one byte at a time: reassembly across arbitrary boundaries
    for i in range(len(stream)):
        for ev, pl in dec.feed(stream[i:i + 1]):
            for line in sess.handle(ev, pl):
                print(line)

    assert sess.frames == 7, f"expected 7 valid frames, got {sess.frames}"
    assert sess.chk_fails >= 2, "both corrupted frames must be flagged"
    assert sess.prev.ver == 21 and sess.prev.boot == 2
    assert sess.gaps > 0, "seq discontinuity must be counted"
    print("selftest:", sess.summary())

    # the yield ledger and the beam math: three consecutive v2.1 frames
    # with known counter climbs, a clear in the middle that must NOT
    # count backward, and a fluence that turns totals into cross-sections
    s2 = Session()
    d2 = Decoder()
    beam = (make_frame21(1, 0x10, esc_a=0, esc_b=0)
            + make_frame21(2, 0x20, esc_a=3, esc_b=1)     # +3 ESC_A, +1 ESC_B
            + make_frame21(3, 0x30, esc_a=5, esc_b=1)     # +2 ESC_A
            + make_frame21(4, 0x40, esc_a=0, esc_b=0)     # CLEAR: no negatives
            + make_frame21(5, 0x50, esc_a=1, esc_b=0))    # +1 ESC_A
    for ev, pl in d2.feed(beam):
        s2.handle(ev, pl)
    assert s2.totals["escape"] == 6, s2.totals
    assert s2.totals["esc_b"] == 1, s2.totals
    rep = s2.report_dict(fluence_cm2=1.0e6, meta={"ion": "selftest"})
    assert abs(rep["cross_section_cm2"]["escape"] - 6e-6) < 1e-12
    print(f"beam math: totals {s2.totals['escape']}/{s2.totals['esc_b']}, "
          f"sigma(ESC_A) {rep['cross_section_cm2']['escape']:.1e} cm2")

    # the dual-voice cross-check: primary drowned in garbage, mirror pure
    prim, mir = Session(), Session()
    dp, dm = Decoder(), Decoder()
    frames = [make_frame21(i, 0x60 + i) for i in range(1, 6)]
    import os as _os
    junk = bytes(b for b in _os.urandom(600) if b != 0x5A)
    flooded = junk[:300] + frames[0] + junk[300:] + frames[1]
    pure = b"".join(frames)
    for ev, pl in dp.feed(flooded):
        prim.handle(ev, pl)
    for ev, pl in dm.feed(pure):
        mir.handle(ev, pl)
    c = crosscheck(prim, mir)
    assert c["mirror_clean"], c
    assert c["flood_suspected"], c
    print(crosscheck_line(prim, mir))
    print("selftest PASS")


def main():
    ap = argparse.ArgumentParser(description="ZIRH telemetry decoder")
    src = ap.add_mutually_exclusive_group(required=True)
    src.add_argument("--port", help="serial port, e.g. /dev/ttyUSB0")
    src.add_argument("--file", help="decode a raw capture file")
    src.add_argument("--selftest", action="store_true")
    ap.add_argument("--baud", type=int, default=115200)
    ap.add_argument("--csv", help="append machine-readable log to this file")
    ap.add_argument("--show-echo", action="store_true",
                    help="print non-frame bytes as well")
    ap.add_argument("--campaign", action="store_true",
                    help="run the injection campaign over the command set "
                         "(requires --port)")
    ap.add_argument("--mirror-port",
                    help="second serial input: the TLM_MIRROR pin; frames "
                         "from both voices are decoded and cross-checked")
    ap.add_argument("--mirror-file",
                    help="offline capture of the mirror stream")
    ap.add_argument("--fluence", type=float, default=0.0,
                    help="run fluence in particles/cm2: turns event totals "
                         "into per-channel cross-sections")
    ap.add_argument("--flux", type=float, default=0.0)
    ap.add_argument("--facility", default="")
    ap.add_argument("--ion", default="")
    ap.add_argument("--let", type=float, default=0.0,
                    help="LET in MeV cm2/mg (bookkeeping)")
    ap.add_argument("--report",
                    help="write the run report (totals, cross-sections, "
                         "dual-voice cross-check) as JSON here")
    args = ap.parse_args()

    if args.selftest:
        selftest()
        return

    csv = open(args.csv, "a") if args.csv else None
    sess = Session(csv=csv)
    dec = Decoder()
    msess = Session() if (args.mirror_port or args.mirror_file) else None
    mdec = Decoder() if msess else None

    def pump(chunk):
        for ev, pl in dec.feed(chunk):
            for line in sess.handle(ev, pl, quiet_skips=not args.show_echo):
                print(line, flush=True)

    def pump_mirror(chunk):
        for ev, pl in mdec.feed(chunk):
            for line in msess.handle(ev, pl, quiet_skips=True):
                print("MIRROR " + line, flush=True)

    try:
        if args.file:
            with open(args.file, "rb") as f:
                pump(f.read())
            if args.mirror_file:
                with open(args.mirror_file, "rb") as f:
                    pump_mirror(f.read())
        else:
            import serial  # pyserial, only needed for live mode
            with serial.Serial(args.port, args.baud, timeout=0.2) as sp:
                if args.campaign:
                    ok = campaign(sp, sess, dec, pump)
                    raise SystemExit(0 if ok else 1)
                msp = None
                if args.mirror_port:
                    msp = serial.Serial(args.mirror_port, args.baud,
                                        timeout=0.05)
                print(f"listening on {args.port} @ {args.baud} 8N1 "
                      "(ctrl-C to stop)")
                while True:
                    pump(sp.read(256))
                    if msp:
                        pump_mirror(msp.read(256))
    except KeyboardInterrupt:
        pass
    finally:
        print(sess.summary())
        if msess:
            print("mirror:", msess.summary())
            print(crosscheck_line(sess, msess))
        if args.report:
            meta = {"facility": args.facility, "ion": args.ion,
                    "let_mev_cm2_mg": args.let, "flux_cm2_s": args.flux}
            rep = sess.report_dict(args.fluence, meta)
            if msess:
                rep["mirror"] = msess.report_dict()
                rep["dual_voice"] = crosscheck(sess, msess)
            with open(args.report, "w") as f:
                json.dump(rep, f, indent=2)
            print(f"report written: {args.report}")
        if csv:
            csv.close()


if __name__ == "__main__":
    main()
