Melihakbulut221/zirh2/macro/hardened32/zirh_tmr_ff32.nl.v

module zirh_tmr_ff32 (clk,
    rst_n,
    d_i,
    q_o);
 input clk;
 input rst_n;
 input [31:0] d_i;
 output [31:0] q_o;

 wire net1;
 wire net2;
 wire net3;
 wire net4;
 wire net5;
 wire net6;
 wire net7;
 wire net8;
 wire net9;
 wire net10;
 wire net11;
 wire net12;
 wire net13;
 wire net14;
 wire net15;
 wire net16;
 wire net17;
 wire net18;
 wire net19;
 wire net20;
 wire net21;
 wire net22;
 wire net23;
 wire net24;
 wire net25;
 wire net26;
 wire net27;
 wire net28;
 wire net29;
 wire net30;
 wire net31;
 wire net32;
 wire net34;
 wire net35;
 wire net36;
 wire net37;
 wire net38;
 wire net39;
 wire net40;
 wire net41;
 wire net42;
 wire net43;
 wire net44;
 wire net45;
 wire net46;
 wire net47;
 wire net48;
 wire net49;
 wire net50;
 wire net51;
 wire net52;
 wire net53;
 wire net54;
 wire net55;
 wire net56;
 wire net57;
 wire net58;
 wire net59;
 wire net60;
 wire net61;
 wire net62;
 wire net63;
 wire net64;
 wire net65;
 wire net33;
 wire \u_core/_000_ ;
 wire \u_core/_001_ ;
 wire \u_core/_002_ ;
 wire \u_core/_003_ ;
 wire \u_core/_004_ ;
 wire \u_core/_005_ ;
 wire \u_core/_006_ ;
 wire \u_core/_007_ ;
 wire \u_core/_008_ ;
 wire \u_core/_009_ ;
 wire \u_core/_010_ ;
 wire \u_core/_011_ ;
 wire \u_core/_012_ ;
 wire \u_core/_013_ ;
 wire \u_core/_014_ ;
 wire \u_core/_015_ ;
 wire \u_core/_016_ ;
 wire \u_core/_017_ ;
 wire \u_core/_018_ ;
 wire \u_core/_019_ ;
 wire \u_core/_020_ ;
 wire \u_core/_021_ ;
 wire \u_core/_022_ ;
 wire \u_core/_023_ ;
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
    .X(\u_core/net67 ));
 sg13g2_buf_1 \u_core/fanout68  (.A(\u_core/net70 ),
    .X(\u_core/net68 ));
 sg13g2_buf_1 \u_core/fanout69  (.A(\u_core/net70 ),
    .X(\u_core/net69 ));
 sg13g2_buf_1 \u_core/fanout70  (.A(net33),
    .X(\u_core/net70 ));
endmodule
