Melihakbulut221/zirh2/macro/hardened64/zirh_tmr_ff64.nl.v

module zirh_tmr_ff64 (clk,
    rst_n,
    d_i,
    q_o);
 input clk;
 input rst_n;
 input [63:0] d_i;
 output [63:0] q_o;

 wire net1;
 wire net2;
 wire net3;
 wire net4;
 wire net5;
 wire net6;
 wire net7;
 wire net8;
 wire net9;
 wire net10;
 wire net11;
 wire net12;
 wire net13;
 wire net14;
 wire net15;
 wire net16;
 wire net17;
 wire net18;
 wire net19;
 wire net20;
 wire net21;
 wire net22;
 wire net23;
 wire net24;
 wire net25;
 wire net26;
 wire net27;
 wire net28;
 wire net29;
 wire net30;
 wire net31;
 wire net32;
 wire net33;
 wire net34;
 wire net35;
 wire net36;
 wire net37;
 wire net38;
 wire net39;
 wire net40;
 wire net41;
 wire net42;
 wire net43;
 wire net44;
 wire net45;
 wire net46;
 wire net47;
 wire net48;
 wire net49;
 wire net50;
 wire net51;
 wire net52;
 wire net53;
 wire net54;
 wire net55;
 wire net56;
 wire net57;
 wire net58;
 wire net59;
 wire net60;
 wire net61;
 wire net62;
 wire net63;
 wire net64;
 wire net66;
 wire net67;
 wire net68;
 wire net69;
 wire net70;
 wire net71;
 wire net72;
 wire net73;
 wire net74;
 wire net75;
 wire net76;
 wire net77;
 wire net78;
 wire net79;
 wire net80;
 wire net81;
 wire net82;
 wire net83;
 wire net84;
 wire net85;
 wire net86;
 wire net87;
 wire net88;
 wire net89;
 wire net90;
 wire net91;
 wire net92;
 wire net93;
 wire net94;
 wire net95;
 wire net96;
 wire net97;
 wire net98;
 wire net99;
 wire net100;
 wire net101;
 wire net102;
 wire net103;
 wire net104;
 wire net105;
 wire net106;
 wire net107;
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
    .D(\u_core/_063_ ),
    .Q(net73),
    .CLK(clknet_4_0_0_clk));
 sg13g2_tiehi \u_core/_255__141  (.L_HI(net140));
 sg13g2_buf_1 \u_core/fanout130  (.A(\u_core/net132 ),
    .X(\u_core/net130 ));
 sg13g2_buf_1 \u_core/fanout131  (.A(\u_core/net132 ),
    .X(\u_core/net131 ));
 sg13g2_buf_1 \u_core/fanout132  (.A(net65),
    .X(\u_core/net132 ));
 sg13g2_buf_1 \u_core/fanout133  (.A(\u_core/net134 ),
    .X(\u_core/net133 ));
 sg13g2_buf_1 \u_core/fanout134  (.A(net65),
    .X(\u_core/net134 ));
 sg13g2_buf_1 \u_core/fanout135  (.A(\u_core/net136 ),
    .X(\u_core/net135 ));
 sg13g2_buf_1 \u_core/fanout136  (.A(\u_core/net139 ),
    .X(\u_core/net136 ));
 sg13g2_buf_1 \u_core/fanout137  (.A(\u_core/net138 ),
    .X(\u_core/net137 ));
 sg13g2_buf_1 \u_core/fanout138  (.A(\u_core/net139 ),
    .X(\u_core/net138 ));
 sg13g2_buf_1 \u_core/fanout139  (.A(net65),
    .X(\u_core/net139 ));
endmodule
