Melihakbulut221/zirh2/fw/zirh_regs.h

/* GENERATED from regmap.yaml by scripts/regmap_gen.py - do
 * not edit. Include after zirh.h or standalone. */
#ifndef ZIRH_REGS_H
#define ZIRH_REGS_H

#define UART_BASE_ADDR 0x00002000u
#define UART_STATUS_ADDR 0x00002000u
#define UART_TXDATA_ADDR 0x00002004u
#define UART_RXDATA_ADDR 0x00002008u
#define UART_BAUD_ADDR 0x0000200Cu

#define HK_BASE_ADDR 0x00003000u
#define HK_ID_ADDR 0x00003000u
#define HK_CTRL_ADDR 0x00003004u
#define HK_CPU_SIG_ADDR 0x00003008u
#define HK_INJECT_ADDR 0x0000300Cu
#define HK_CNT_PLAIN_ADDR 0x00003010u
#define HK_CNT_RAW_A_ADDR 0x00003014u
#define HK_CNT_ESC_A_ADDR 0x00003018u
#define HK_CNT_RAW_B_ADDR 0x0000301Cu
#define HK_CNT_ESC_B_ADDR 0x00003020u
#define HK_CNT_ECC_C_ADDR 0x00003024u
#define HK_CNT_ECC_U_ADDR 0x00003028u
#define HK_CNT_BUSTO_ADDR 0x0000302Cu
#define HK_CNT_FERR_ADDR 0x00003030u
#define HK_BOOT_CNT_ADDR 0x00003034u
#define HK_ENV_RO_ADDR 0x00003038u
#define HK_ENV_SB_ADDR 0x0000303Cu

#define IFC_BASE_ADDR 0x00003040u
#define IFC_CAN_STAT_ADDR 0x00003040u
#define IFC_CAN_CTRL_ADDR 0x00003044u
#define IFC_SPW_STAT_ADDR 0x00003048u
#define IFC_SPW_CTRL_ADDR 0x0000304Cu

#endif
