Melihakbulut221/zirh2/src/zirh_tmr_ff64.v

// =============================================================================
// ZIRH-2 - concrete wrapper for one constrained-chain replica
// zirh_tmr_ff64.v
//
// The A-chain of zirh_hk instantiates this named module instead of the
// parameterized zirh_tmr_ff directly, so that at hardening time the three
// instances can be bound to a pre-hardened macro (LibreLane MACROS object,
// mechanism proven in docs/ZIRH2-SCOPE.md phase 4) and pinned to separated
// coordinates. In simulation and unconstrained synthesis it is identical
// to zirh_tmr_ff #(64).
// =============================================================================

`default_nettype none

(* keep_hierarchy *)
module zirh_tmr_ff64 (
    input  wire         clk,
    input  wire         rst_n,
    input  wire [63:0] d_i,
    output wire [63:0] q_o
);

  zirh_tmr_ff #(
      .WIDTH (64)
  ) u_core (
      .clk   (clk),
      .rst_n (rst_n),
      .d_i   (d_i),
      .q_o   (q_o)
  );

endmodule

`default_nettype wire
