Melihakbulut221/zirh2/(commit log)

2026-08-07 ZIRH-2: migrate the chip from the zirh development branch
    Everything the 8x2 chip needs, moved from zirh@zirh2-p0 where it was
    built and verified: 28 RTL sources (SERV 1.3.0 vendored at 0cf26fe),
    the committed mask-ROM include, firmware tree with its CI build
    workflow, eleven test suites with the TT-harness integration test now
    running at silicon parameters, ten synthesis integrity checks, the
    hardened chain-A macro with its binding in src/config.json (MACROS at
    the coordinates the binding probe verified to 0.00 um), the ground
    station, the placement measurement tool, and the frozen pin map with
    the engineering record.
    Two lessons from ZIRH-1 are baked in from commit one: the repository
    com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
    [main.c, rom_gen.py, tb.v, test_ecc_ram.py, test_hk.py, test_rom.py, test_soc.py]
2026-08-07 GL sim: link the chain-A macro's own gate netlist
    The top's gate-level netlist carries the three zirh_tmr_ff64 macros as
    blackboxes - correct, they hardened separately - so the GL compile
    needs their netlist from the hardened deliverables. First zirh2 GL run
    failed with 'Unknown module type: zirh_tmr_ff64' on exactly this.
2026-08-07 Cap the chain-A macro at Metal5 so the chip PDN can cross it [skip ci]
    DEF geometry from the first integration: the vertical TopMetal1 power
    stripes split at every macro column (3.6-91.6 um below, 221.1-310.6 um
    above - the macro spans 90-222.47), because the macro's own hardening
    used the full stack and left TopMetal1/2 geometry the chip PDN cannot
    stripe over. TT precheck rejected the split stubs as ports more than
    10 um from the die edge. Capped at Metal5 with its internal PDN on
    Metal4/Metal5 and a core ring, the chip's TopMetal straps pass over
    and via down. The macro64 workflow gates on zero TopMetal entries in
    the LEF.
2026-08-07 Swap in the Metal5-capped chain-A macro deliverables
    Same 113.75 x 132.47 um footprint - the binding coordinates stay valid -
    with zero TopMetal geometry in the LEF (workflow-gated), so the chip's
    TopMetal1/2 power stripes can now cross the macro columns unbroken.
    Clean DRC/LVS, 64 flops, setup +14.8 ns standalone.
2026-08-07 Connect the chip PDN down onto the capped macros: custom PDN_CFG
    LibreLane's default macro grid carries exactly one connect rule -
    PDN_VERTICAL_LAYER to PDN_HORIZONTAL_LAYER, i.e. TopMetal1 to
    TopMetal2 - which never touches the Metal4/Metal5 power pins of a
    macro whose stack was deliberately capped so the chip stripes could
    cross it. Measured failure: PDN-0232 'does not contain any shapes or
    vias' for all three chain-A instances, then PDN-0233. src/pdn.tcl is
    the byte-for-byte default plus two marked connect rules (Metal5 to
    TopMetal1, Metal4 to Metal5), selected via PDN_CFG.
2026-08-07 Record the PDN/macro integration road to the first all-green CI [skip ci]
    Three measured layers: TopMetal-bearing macro splitting the chip
    stripes (fixed by the Metal5 cap, gated in the macro workflow),
    LibreLane's default macro grid never connecting below the TopMetals on
    IHP's stack (fixed by the marked rules in src/pdn.tcl), and GL linking
    of the macro netlist. Chain A bound at 700/680/1380 um, chain B
    tool-placed, every gate green in one run.
2026-08-07 Close the loop the pins left open: watchdog, commands, frame v2.1
    The housekeeping block gains the CPU watchdog (a TMR'd cycle counter
    cleared by every firmware signature write; on 2^20 silent cycles it
    resets ONLY the SoC for 16 cycles and increments a TMR'd BOOT counter -
    a dead computer becomes a counted, recovered event) plus counters for
    the two previously invisible event classes, bus timeouts and UART frame
    errors. The telemetry frame grows to 20 bytes under a new '5A 33'
    marker, carrying BOOT/BUS_TO/RX_FERR beside everything v2 had.
    Firmware v2 restores "the chip is its own test bench" over the UART:
    one-byte commands fire all five injection paths, switch patterns,
    clear counters, an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
    [main.c, tt_um_hma_zirh2.v]
2026-08-08 The v2.1 package: commands, watchdog, wider frame, campaign
    One approved batch. The UART command set closes the loop the pin map
    left open - injections, modes, clear and a boot-time ROM checksum all
    reachable from the ground, everything else still echoing incremented.
    The CPU watchdog turns a dead computer into a counted, recovered
    event: TMR'd cycle counter fed by signature writes, SoC-only reset,
    BOOT in telemetry. Bus timeouts and UART frame errors, previously
    invisible, now count. The frame grows to 20 bytes under '5A 33' and
    the ground station decodes all three generations plus flags climbing
    BOOT as a reboot; its campaign mode fires every injection path over
    the command set and checks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
    [main.c, test.py, test_campaign.py, test_hk.py, test_tlm2.py, zirh_ground.py]
2026-08-08 Pin the restart firmware: new mask ROM, checksum 0xE1, cache fix
    The CI rebuild with the voluntary warm restart lands as rom.hex and
    the regenerated rom_init.vh. Flop counts did not move: the SoC stays
    at 2158 and the top at 3382, so the synthesis gates stand as they are.
    The committed-mask checksum becomes 0xE1 and the integration test
    expects it.
    Two things the re-verification caught. The SoC suite still waited the
    pre-checksum 30k boot cycles and sampled the loop counter while the
    CPU was still folding the ROM - now 120k like the integration suite.
    And rom_init.vh is an include, invisible to VERILOG_SOURCES, so a
    regenerated ROM silently reused a stale sim.vvp - the old mask kept
    answeri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
    [test.py, test_soc.py]
2026-08-08 The v2.2 environment instruments: TID, SET, burst
    Widens the tile from an SEU counter into a combined radiation-effects
    observatory, with zero new pins and the frame untouched - three
    instruments answering on the UART command path from hk's two free
    registers (0x38/0x3C):
    'T' gates a 64-stage ring oscillator into an async ripple counter for
    a fixed 1024-cycle window; total ionizing dose drifts the frequency,
    so repeated readings plot the accumulated-dose curve (ring-oscillator
    dosimetry is demonstrated in the literature from 250 nm bulk down to
    22 nm FD-SOI). 'S' reads a cross-coupled NAND catch latch watching a
    quiet 64-stage inverter chain - the classic self-triggered capture of
    single-ev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
    [main.c, test.py, test_env.py, test_hk.py, test_z2.py, tt_um_hma_zirh2.v, zirh.h]
2026-08-08 Pin the v2.2 mask: env commands live, checksum 0x2B
    The CI rebuild with the T/S/B/E command branches lands as rom.hex and
    the regenerated rom_init.vh; the committed-mask checksum becomes 0x2B.
    The synthesis gates did not move - the SoC holds 2158 and the top 3509,
    measured against the new constants - so only the checksum expectation
    changes.
    One test taught something again: the boot zero-fill check hardcoded
    "the stack reaches word ~8", and the v2.2 command branches deepened
    main's frame past it, leaking never-written callee-saved X into the
    "provably untouched middle". The check now finds the stack boundary
    empirically - X words are exempt stack slots, everything below must be
    exactly zero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
    [test.py, test_soc.py]
2026-08-08 Wide-scenario suites: fuzzer, TMR flip sweep, reboot storm
    Three new top-level suites push past the happy path.
    test_fuzz: 400 random bytes with random pacing - every illegal byte,
    back-to-back overruns, commands colliding with telemetry. Frames must
    keep flowing with valid checksums, no TMR infrastructure fault may
    appear, and afterwards a clear returns the instrument to zero and the
    CPU still echoes. Nothing an operator can type wedges the chip.
    test_tmrflip: a single-replica flip forced through one clock edge in
    EVERY TMR island on the die - 14 housekeeping registers, both telemetry
    registers, all four env registers, two rounds - must reconverge within
    cycles and pulse the mismatch dete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
    [test_fuzz.py, test_storm.py, test_tmrflip.py]
2026-08-08 The targeted interfaces land: CAN 2.0A-lite and SpaceWire-lite
    The two links the scope staged as P1 and P2, pulled onto the die as
    beam experiments. The design center, straight from the fault-tolerant
    FSM literature: every protocol state machine is a TMR register with
    voted feedback PLUS a safe-state trap - the unreachable encodings fall
    into the protocol's own recovery state (SpaceWire's ErrorReset, CAN's
    bus integration) instead of wedging. Datapaths and serial CRCs stay
    plain on purpose: they are what the beam is for.
    zirh_can, 2 pins: standard data frames bit-faithful through stuffing,
    CRC-15, the ACK handshake and EOF; no arbitration or retransmission
    (one node on a looped bench). The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
    [main.c, test.py, test_can.py, test_spw.py, tt_um_hma_zirh2.v, zirh.h, zirh_can.v]
2026-08-08 Pin the interface mask and pay two alignment debts
    The CI rebuild with the k/K/w/W command branches lands as rom.hex and
    rom_init.vh; the committed-mask checksum becomes 0xBC (196 of 256 ROM
    words now in use) and the firmware-dependent counts move two flops -
    SoC 2160, top 3887.
    The end-to-end run against the real mask caught two bugs the unit
    suites could not see. The CAN transmitter's FSM leads its own wire by
    one slot - a state moves when a bit is LOADED, the bit appears a slot
    later - so it sampled the ACK during the wire's CRC delimiter; at the
    unit suite's fast bit clock the loopback's four-clock skew happened to
    span a whole bit and masked it. T_ACK is now two bits wide, first the
    de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
    [test.py, zirh_can.v, zirh_spw.v]
2026-08-08 Fit the pull-in: honest clock target, honest density target
    The interface commit died in detailed placement (DPL-0036, the 8x2
    probe's old death) - but not for want of area alone. Two constraints
    were lying to the tools. The clock period said 20 ns on a chip that
    runs at 20 MHz: a 2.5x overconstraint that made the post-CTS resizer
    inflate 1903 timing-repair buffers into a die whose movable area was
    already 76% of the core. And the placement target said spread to 60%,
    an impossible goal at 76% occupancy, so legalization inherited an
    incoherent placement and gave up.
    CLOCK_PERIOD becomes 40 ns - a 25 MHz target, still 25% above
    nominal, and the prior runs' measured fmax (~74 MHz at the old
    co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
2026-08-08 Raise the placement target above actual utilization
    Second DPL-0036, same post-CTS repair step, and the numbers explain
    it: effective utilization is 76.8%, and 73 - like 60 before it - is
    BELOW reality, which hands global placement a spread goal it cannot
    meet and legalization inherits the mess. The target must exceed the
    actual utilization; 78 clears it with headroom for the hold-repair
    buffers while staying under the ~86% cliff the first 8x2 probe
    measured. The unplaceable-instance list of the failed run was a few
    dozen cells - this is a margin problem, not an area wall.
2026-08-08 Move the chain-A macros out of the placement fairway
    Third DPL-0036 at the same post-CTS repair step, and raising the
    density target made legalization worse (40 unplaced became 230) -
    which says the wall was never average density. The three hardened
    chain-A macros sat at y=90 in a 306 um core: a 132 um tall block
    parked mid-height splits every row it spans into short placement
    islands, and the repair buffers that must land near the clock tree
    had no contiguous rows left. All three macros drop flush to the
    bottom edge (y=7.56, row-aligned, one legalization row under the
    halo); the A/B separation experiment is untouched - the x positions
    and 700/680 um spacings stand - and the rows above the m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
2026-08-08 Skip the pre-route hold repair; let the routed one do its job
    Fourth DPL-0036, all four inside ResizerTimingPostCTS, indifferent to
    density targets (60/73/78/75) and to macro placement (mid-height and
    bottom-edge both measured): the step itself is the problem. It
    repairs hold against pre-route parasitic estimates and on this die
    that guess inflates ~1900 buffers into a core already 77% full - then
    its own legalization cannot land them. The post-GRT resizer repairs
    the same hold against real routed parasitics and inserts only what
    the wires actually need; signoff STA still gates the result, so a
    genuine hold violation still fails the run. No RTL, no science, one
    flow switch.
2026-08-08 Turn on the repair the margin was aimed at
    Two runs with byte-identical hold results (-122 ps, 2232 endpoints)
    exposed the real state of things: this flow ships with the post-GRT
    resizer DISABLED, so after the pre-route repair was switched off no
    hold fixing ran at all - the margin knob was connected to nothing.
    RUN_POST_GRT_RESIZER_TIMING goes true: hold is now repaired exactly
    once, against real routed parasitics, aiming at the 0.25 ns margin,
    on a die with 23 ns of setup slack and five points of area to spend.
    Signoff STA still judges.
2026-08-08 Distribute the free area to where the repair cells must land
    Seventh look at the same wall found its footing: GPL_CELL_PADDING was
    zero, so global placement packed every row solid and the die's 19%
    free area pooled in clumps far from any net - which is why BOTH
    repair passes, pre-route (~1900 cells) and post-route (1000+), died
    in legalization despite ample total space: repair cells must sit
    next to the nets they fix, and there were no slots there. One site
    of global-placement padding leaves that slack beside every cell;
    legalization padding stays zero so DPL may still pack tight where it
    must. Hold margin comes back to 0.1 to keep the insertion volume to
    what -122 ps actually needs.
2026-08-08 Stage the N=32 chain-A macro
    Directed decision after eight DPL-0036s: the interfaces stay and the
    monitor rings shrink to N=32, halving both the ring flops and the
    hardened macro footprint - the A/B placement experiment survives with
    half the per-pass statistics, which beam time can repay. This commit
    stages the macro side: the zirh_tmr_ff32 wrapper, its LibreLane
    config (same Metal5 cap and PDN discipline as the 64), and a matrix
    entry in the macro workflow. The hardened deliverables land in the
    next commit once the workflow run produces them.
2026-08-08 Give the N=32 macro its own workflow
    The matrix entry staged earlier targeted the old repository's macro
    workflow shape and silently matched nothing - macro64.yaml here is a
    single job. macro32.yaml is its faithful clone at N=32: same Metal5
    cap, same TopMetal-free LEF gate, 32-flop netlist gate.
2026-08-08 The N=32 shrink lands: rings halve, macros shrink 43%, all suites green
    The directed trade after eight DPL-0036s: both interfaces stay, the
    monitor rings drop from N=64 to N=32. The A/B experiment is intact -
    same constrained three-macro chain against the tool-placed control,
    same injection semantics - at half the per-pass capture statistics,
    which beam time repays. The zirh_tmr_ff32 macro hardened under the
    same Metal5/PDN discipline at 83.8 x 102.5 um (8.6k um2, 43% below
    the ff64); its three instances return ~20k um2 of core and the ring
    flops another ~7k. Housekeeping measures 706 flops, the top 3660.
    The proven flow settings stay: pre-route repair off, post-GRT repair
    at 0.1 margin, one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
2026-08-08 The interface inventory completes: telemetry mirror on uio[7]
    Directed overnight: UART, CAN, RS-232, RS-422, SpaceWire all aboard.
    The ledger: the UART is the main link (ui[3]/uo[4]); CAN sits on
    uio[0:1]; SpaceWire on uio[2:5]; and RS-232 versus RS-422 has always
    been a transceiver choice at the bench, not a chip distinction - what
    the chip owes is a second, independent serial pin, and last night's
    storm campaign measured exactly why: a deranged CPU can flood the
    shared UART until telemetry frames drown in the garbage.
    zirh_tlm_mirror is that pin (uio[7], TLM_MIRROR): a transmit-only 8N1
    serial port fed directly by the TMR'd framer's byte handshake,
    upstream of the shared UART. It sits on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
2026-08-09 Trim the hold margin to what the last fifteen cells need gone
    Eleven runs in, the homeless count reads 230, 53, 30, 15 - and the
    fifteen are one clone burst from a single high-fanout net's repair.
    The 0.1 margin asked for repair 60% past the actual -122 ps debt and
    the spread placement answered with 2654 insertions; 0.06 still clears
    the debt at every corner with margin to spare and thins exactly the
    kind of burst that is left standing. The checkers still gate: a real
    hold violation fails the run.
2026-08-09 Let the legalizer reach over the macro band
    Homeless count: 230, 53, 30, 15, ten - and the ten are hold buffers
    for one contiguous flop bank whose rows are packed. The detailed
    placer's vertical search radius is 100 um on a 306 um die whose
    bottom 102 um is macro in three spans: a cell that must hop the band
    to find a row cannot. PL_MAX_DISPLACEMENT_Y goes to 250 - any row is
    reachable from any row - at the cost of those ten buffers landing a
    little farther from ideal, which the 0.06 margin absorbs.
2026-08-09 Marathon suites: everything-on soak, cardiogram, flip-storm rounds
    Scale directive: run very large scenarios on the final configuration.
    Three new endurance tests in test_mega.py, all three green in one
    250-million-nanosecond run:
    EVERYTHING-ON SOAK - SpaceWire held in Run, CAN beacons firing, 120
    random command bursts spanning injections, environment polls,
    interface queries and echoes, while BOTH telemetry voices are decoded
    concurrently: primary and mirror each delivered 107 checksum-valid
    frames, the mirror with zero bad bytes (it carries only frames, by
    construction), zero TMR infrastructure faults, CAN error-free, and
    the CPU still echoing at the end.
    TWO-HUNDRED-FRAME CARDIOGRAM - c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
    [test_campaign.py, test_mega.py]
2026-08-09 The roadmap lands and cycle 1 opens: scrub the register file at boot
    Two independent analyses - commercial and systems-engineering - were
    run over the whole program and intersected in docs/ROADMAP.md: a
    DO-NOW queue of eight software/firmware/test items (the die is frozen
    at 83.3%), a ranked ZIRH-3 silicon backlog, and the product track
    that rides on beam credibility. The standing loop: build the top
    item, test it, record it, re-rank.
    Cycle 1 is the item everything else baselines against: thirty-one
    writes at the top of crt0 scrub the register file before anything
    runs. Measured reason: SERV's RF is a RAM the SoC reset does not
    wipe, so a watchdog reboot lands in stale - possibly corrupted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
2026-08-09 Pin the scrubbed mask: checksum 0xF4, counts unmoved
    The register-file scrub lands as rom.hex and rom_init.vh; the
    committed-mask checksum becomes 0xF4 at 227 of 256 words used, and
    for once the firmware-dependent synthesis counts did not move - SoC
    2160, top 3690, all sixteen check_tmr gates standing as they are.
    Local against the scrubbed mask: soc 3/3, integration 6/6, z2 3/3.
    Cycle 1 closes in the roadmap; cycle 2 is the TMR-Guard manifest CLI.
2026-08-09 Cycle 2: tmr-guard, the independent TMR survival verifier
    The sharpest commercial finding of the program analysis, shipped as a
    tool: synthesis deletes hand-built TMR silently (79 flops became 26
    in this repository's founding experiment, and the netlist simulated
    identically), insertion tools grade their own homework, and nothing
    independent checks the netlist you ship. scripts/tmr_guard.py is that
    independent check - manifest-driven (JSON or YAML: sources, replica
    pattern, expected instance and flip-flop counts per block), PDK-free
    (replica merging happens in the early opt passes, so each check is
    seconds of Yosys), machine-readable reports for CI and attestation.
    The differentiating half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
2026-08-09 Cycle 3: the fault campaign reaches the netlist that flies
    The RTL campaigns proved the survived/rebooted/zombie contract on the
    source; this puts it on the shipped gates. test_gl_campaign.py joins
    the existing gl_test CI job through the Makefile module list under
    GATES=yes (RTL runs skip it), so every gds run now fault-injects its
    own freshly routed netlist with no workflow changes.
    Targets come from the netlist itself, because synthesis rewrote the
    map: of 3594 flops, 1174 keep their keep_hierarchy island prefixes
    and 2420 are anonymous _N_ core flops whose hierarchy dissolved -
    SERV, the register file, the glue. The test parses instances with
    their Q nets, classifies replica islands vers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
    [test_gl_campaign.py]
2026-08-09 Cycle 4: the fault-campaign contract becomes a library
    Every campaign this program wrote - RF flips, storms, marathons, the
    gate-level run - carried its own copy of the same outcome logic.
    host/zirh_campaign.py is that logic factored into one importable place,
    which is also the seed of the qualification-pipeline product: the
    zombie taxonomy is the thing no watchdog scheme on the market can see,
    and here it is an API.
    The pieces: an Outcome enum and a judge() that encodes the measured
    contract (survived / rebooted / zombie / the one forbidden SILENT), an
    InjectionSpec DSL that says WHAT to hit (target class plus count) so
    the same script drives a cocotb force, a serial command to a twin, or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
    [test_zirh_campaign.py, zirh_campaign.py]
2026-08-09 Cycle 5: the ground console learns the beam's arithmetic
    Beam time runs on the order of three thousand dollars an hour; the
    number a shift exists to produce is a cross-section, and until now the
    console could only stream frames. The session now keeps a clear-aware
    per-channel yield ledger - positive counter deltas summed, a CLEAR
    contributing nothing - and --fluence turns it into per-channel
    cross-sections. --report writes the whole run as JSON with the
    JESD57A-shaped metadata (facility, ion, LET, flux) the data reduction
    wants attached, and it works identically on a live port or an offline
    capture file.
    The mirror pin gets its software half. --mirror-port and --mirror-file
    run a second dec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
2026-08-09 Cycle 6: the STA robustness sweep, built on a corrected premise
    The roadmap said seed sweep; the tools said otherwise - OpenROAD's
    placer is deterministic and resolved.json carries no seed variable,
    so sweeping a seed would have measured nothing. Robustness is probed
    the honest way instead: four hardening runs of the winning recipe
    with small perturbations - baseline, density one point down, one
    point up, and the clock period nudged to 39 ns. If the +27 ps
    fast-corner hold survives all four, it is a property of the recipe;
    if any point flips negative, the knife-edge is real and documented.
    The workflow (manual trigger - four ~50-minute runs are a deliberate
    spend) hardens each point through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
2026-08-09 Cycle 7: the FPGA twin, and the cell that would not map
    The first bitstream build found the real blocker, and it was not the
    ECC RAM the feasibility note worried about: the environment
    instruments' ring oscillator and SET catcher hand-instantiate SG13G2
    inverters and NANDs, and iCE40 has no mapping for them. The ECC RAM's
    combinational read maps to logic fine; the analog-adjacent cells do
    not exist off the PDK.
    The fix is at the RTL and it is honest: both cell modules already
    fall back to a behavioral model under ZIRH_SIM_ENV for cocotb; they
    now also fall back under SYNTH, which the FPGA flow defines and - this
    is the load-bearing check - the SG13G2 ASIC synthesis defines neither
    SYNTH nor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
    [zirh_env.v, zirh_serial_backend.py]
2026-08-09 Cycle 7 cont: the SET catcher is latch-free on the twin
    Past the SG13G2 fix, the FPGA build hit its one remaining assert: the
    SET catcher's behavioral model is a level-sensitive latch, and iCE40
    has no latch primitive. The catch chain is analog-only anyway, so on
    the twin the only stimulus the block can ever see is the firmware's
    two-cycle 'E' self-test pulse - and a pass-through carries that
    exactly (the controller's own two-flop synchronizer still edge-detects
    one catch), with no state element to become a latch. Under SYNTH the
    model is now `caught_o = test_i & arm_n_i`; the cocotb path keeps the
    real latch so the unit suite still exercises arm / hold / re-arm.
    Recorded as a twin/silicon d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
    [zirh_env.v]
2026-08-09 Cycle 7 cont: register the ROM under SYNTH to fit UP5K
    The third build gave the empirical answer the feasibility note left
    open: the full five-interface design synthesizes clean but lands at
    5588 of 5280 iCE40 logic cells - 105%, over by 6%. The old ~3540 LUT
    estimate was the pre-interface v2.1 design; the productized chip does
    not fit UP5K as logic.
    The documented lever, applied: under SYNTH the ROM's two read ports
    are registered so yosys maps the 256x32 array to block RAM instead of
    ~8 Kbit of LUTs. It is timing-safe by construction - the SoC's
    ibus_ack is already one cycle delayed, so a registered fetch delivers
    exactly on the cycle SERV samples the instruction - and it is proven:
    test_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
2026-08-09 Cycle 7 verdict: the twin does not fit UP5K, and now we know exactly
    The FPGA build gave the definitive number the feasibility note only
    estimated: the full five-interface ZIRH-2 is 5565 of 5280 iCE40UP5K
    logic cells - 105%, a 285-cell overflow. The old ~3540 LUT figure was
    the pre-interface v2.1 design; the productized chip is bigger by every
    interface, the environment block and the A/B chains.
    The ROM-to-BRAM lever was real but insufficient - registered reads
    under SYNTH moved the 256x32 array into 8 block RAMs and freed about
    twenty cells, because the bulk is logic (TMR triplication, SERV, five
    protocol engines), not memory. No memory trick closes a 285-cell gap.
    So cycle 7 closes on a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
2026-08-09 Cycle 8: the evidence pack, assembled from what the tools measured
    The tender-blocking tier of the commercial analysis, as a generator:
    host/zirh_evidence.py takes the machine-readable artifacts the loop
    has been producing - a campaign report from the contract library, a
    yield/cross-section report from the ground console, a tmr-guard
    attestation - and assembles one reviewable markdown pack shaped after
    the ECSS-Q-ST-60-15C RHA deliverable structure with JESD57A test
    bookkeeping: device and configuration, test conditions, method and
    the measured outcome taxonomy quoted verbatim, results with
    per-channel cross-sections, mitigation verification quoting the TMR
    attestation together with its nega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
2026-08-09 Cycle 9: the FSM pattern becomes a generator that proves itself
    The safe-state TMR FSM pattern the CAN and SpaceWire engines proved
    under fault injection - voted-feedback state register, case-default
    trap into the protocol's own recovery state - is now a generator.
    scripts/tmr_fsm_gen.py takes a JSON spec (states, recovery, priority-
    ordered transitions over _i inputs) and emits the Verilog; when the
    state count is an exact power of two it widens the register a bit
    rather than ship a trap-free machine, and says so in the header.
    The second output is the reason it exists: the tmr-guard manifest
    entry rides along with the replica and flop counts COMPUTED - one
    register means three cells of on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
2026-08-11 Give the router back its breathing room after the scrub mask
    Four hardening attempts on the scrubbed mask told one story when the
    logs finally opened: synthesis is correct (3594 flops exactly, no
    define leakage), utilization unchanged at 77.8 - but global routing
    now finishes congested and detailed routing plateaus around 6,400
    shorts through eleven optimization iterations, five hours deep. The
    only input that changed since the last green run is the ROM contents:
    thirty-one scrub instructions regenerated the ROM decode logic and
    the new arrangement lands in a local congestion pocket the old one
    happened to avoid.
    The fix is the sweep's own data read in the other direction: 80 broke
    hold, 79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
2026-08-11 Tell global routing the truth about the pocket
    Density spread alone did not clear the scrubbed mask's congestion:
    the second six-hour run still finished global routing congested and
    detailed routing crawled from 23.5k violations down to 5.4k at
    minus three hundred per half-hour iteration - nine more hours of
    grinding it does not have. The router's global capacity assumption
    is the actual lie: at the default 30% adjustment GRT declares the
    pocket routable, hands DRT an overloaded plan under
    -allow_congestion, and DRT pays for it in shorts forever.
    GRT_ADJUSTMENT goes to 0.45: global routing assumes less capacity
    per edge, spreads around the ROM-decode pocket at the global stage
    where spreadi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
2026-08-11 Reroll the placement lottery instead of fighting the pocket
    Three levers, three verdicts, all measured on six-hour runs: the
    original config plateaus detailed routing at 6.4k shorts, one point
    of density spread turns it into a crawl at 5.4k, and squeezing
    global capacity to 45% explodes it to 122k and climbing - capacity
    reduction compresses exactly the pocket it was meant to relieve, so
    GRT_ADJUSTMENT comes back out.
    What remains true: this same netlist at this same utilization routed
    green before the scrub mask rearranged the ROM decode comb - the
    pocket is a bad draw of a deterministic lottery, not a capacity law.
    So this attempt redraws the lottery instead of arguing with it: the
    clock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
2026-08-12 Shrink the boot scrub to the class that matters, to route
    Three placement configs - density 79, density 78, a clock+displacement
    reroll - all ground detailed routing to a congested ~5k-short plateau
    that never converges in six hours. The verdict is consistent and the
    lottery theory is dead: this is structural. The last green gds ran on
    the pre-scrub ROM; the full 31-register scrub is the regression, its
    extra constants reshaping the 256x32 ROM decode mux into a pocket the
    router cannot clear.
    The scrub does not need all 31 registers. The RF-residue finding it
    answers is specifically about a hoisted base pointer surviving in a
    CALLEE-SAVED register across the loop's calls - so ra and s0-s11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
2026-08-12 Pin the subset-scrub mask and restore the winning config
    The callee-saved scrub rebuilt clean in CI: checksum 0xE5, 209 of 256
    ROM words used (down from the full scrub's 196... up, but rearranged),
    flop counts unmoved at 2160/3690, and it boots - soc 3/3, integration
    6/6 on the new mask locally, including the command path and the env
    instruments.
    Config returns to the proven baseline: density 79 (the measured
    hold-clean edge), clock 40 ns, displacement 250, no GRT adjustment.
    The three config rerolls proved the pocket is structural, not a
    placement draw, so the fix belongs in the netlist - the shrunk scrub
    reshapes the ROM decode mux - and the router gets tested against the
    recipe that clos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
    [test.py]
2026-08-12 Record verification closed: nine cycles green on the shipped netlist
    gds, precheck, gl_test and viewer all pass on the full design after
    the fetch-pipeline fix. Utilization 83.3%, hold clean at every corner,
    DRC/LVS/antenna zero, and the GL fault campaign ran in CI for the
    first time - 8/8, the contract proven on the flying netlist. The
    multi-day routing crisis and its root cause are documented; the
    software program is complete.
2026-08-12 Add the twin-lite configuration and fix the twin ROM ack timing
    ZIRH_TWIN_LITE gates the two interface experiments (CAN + SpaceWire,
    loopback-only on the bench) out of the top level and is the default
    whenever SYNTH is defined - the TT FPGA flow is fixed to the UP5K and
    the full design measured 5565 of 5280 LCs there. Their register window
    still acks and reads zero, so 'k'/'K'/'w'/'W' degrade to harmless
    no-ops instead of bus timeouts. A larger-board wrapper defines
    ZIRH_TWIN_FULL to restore the experiments; the ASIC flow defines
    neither and is untouched. Measured: lite drops 733 LUT4s and ~370
    flops, landing around 85% of the UP5K by LUT-ratio scaling - the
    bitstream CI run is the definitiv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
    [tt_um_hma_zirh2.v]
2026-08-12 Register the pre-beam prediction: systematic GL SEU sweep and layout claim
    The beam will measure ESCAPE(A) vs ESCAPE(B); this commit registers
    what the measurement must find before any beam time exists, with the
    git history as the timestamp.
    test_gl_seu_sweep.py joins the gl_test job: 384 exhaustive singles
    (every replica flop of both chains, both pattern phases) must each
    land as exactly one RAW count with zero escapes, and 192 cross-replica
    pairs must map the escape window to same-bit-same-cycle and nothing
    else - simultaneous same-bit pairs escape exactly once each, staggered
    and different-bit pairs never. Green on the shipped netlist at silicon
    timings; the chains are logically indistin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
2026-08-13 Retire the FPGA twin program
    Decision: no twin board. The UP5K cannot hold the full design and the
    proven lite configuration will not be deployed; beam rehearsal is the
    gate-level campaign plus the campaign library, which the systematic
    SEU sweep already exercises end to end on the shipped netlist. The
    fpga workflow is removed. The twin record stays in fpga/README.md
    because the program's two durable products - the ROM ack-timing fix
    and the dormant TWIN guards - are documented there; any future
    revival starts from a proven configuration instead of from scratch.
2026-08-13 Prove the escape window formally and let the solver draw the escape
    The sweep samples the escape window; this proves it. formal/f_ring.sv
    wraps the shipped replica primitive in the shipped voted-feedback
    structure with free upset inputs, and scripts/formal.sh checks it by
    BMC plus unbounded k-induction (yosys-smtbmc, z3) at ring widths 4, 8
    and the shipping 32: under an arbitrary infinite upset stream - any
    bits, any number of bits per cycle, confined to one replica per
    cycle - the voted output equals the golden ring in every bit of every
    cycle. Stronger than the 384-injection sweep on two axes: multi-bit
    upsets within a replica are covered, and upsets arrive every cycle
    forever. The dual co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
2026-08-13 Add the RV32I torture: random programs vs a golden model at the pins
    The riscv-dv idea sized for a 256-word mask ROM. torture_gen.py emits
    random RV32I bodies - ALU, shifts, forward compare-and-skips, loads
    and stores confined to the ECC RAM - each followed by an epilogue
    that folds x1..x15 into a digest and transmits it over the UART
    registers with status polling; a built-in ISS predicts the digest
    independently. tb_torture.v runs the bare SoC; the digest is judged
    at the UART pins, so every program crosses the pipelined instruction
    fetch, the ROM data port, the bus mux and the ECC RAM write path -
    the exact integration modified by hand this cycle. scripts/torture.sh
    compiles once and strea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
    [tb_torture.v, test_torture.py]
2026-08-13 Give the formal job a modern z3 and a fast-fail timeout
    The first CI run proved the theorem locally in minutes and then sat
    in the runner for six hours until GitHub killed the job: the distro
    z3 is generations behind the pip build and crawls on the N=32
    induction. The solver now comes from pip, and both jobs carry
    timeout-minutes so a future solver stall fails in under an hour
    instead of silently holding a runner to the platform limit.
2026-08-13 Bring up the open-PDK SRAM macro in simulation - program P1 first step
    The product program's memory workstream starts where the chain-A
    macros started: prove the model links and behaves before building on
    it. The bare RM_IHPSG13_1P_1024x8 behavioral model (FUNCTIONAL
    define, core + wrapper from the PDK) now runs under cocotb: write,
    one-cycle-latency read, bit-mask merge and write-through all behave
    as the datasheet says. Next: the five-slice 39-bit word wrapper with
    the shared SECDED, then the scrubber.
2026-08-13 Build the sliced SRAM word: five macros, one codeword, same proof
    Program P1's centerpiece. zirh_sram39 is a 1024x32 SECDED memory
    built from five RM_IHPSG13_1P_1024x8 macros - four data slices and a
    parity slice - storing EXACTLY the flop RAM's codeword: the Hamming
    helpers moved verbatim into zirh_secded.vh, both memories include it,
    and the formal SECDED proof re-passed against the refactored flop RAM
    unchanged, so one proof now guards both storages. Beam data from the
    two becomes directly comparable: same code, different storage physics.
    Slicing is the MBU defence: an event footprint confined to one macro
    touches at most one slice of any logical word, and per-word SECDED
    absorbs one bit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
2026-08-13 Land the boot architecture: the ROM becomes a loader
    docs/BOOT.md sets the contract for A5/F25/F26: the mask ROM stops
    being the firmware and becomes an immutable loader plus a golden
    minimal firmware; application images live in external rad-tolerant
    NVM or arrive from the host, and execute from the SECDED SRAM.
    zirh_boot_ctrl.v is the first hardware piece: a transport-agnostic
    byte-stream sink and SRAM bus master with TMR state whose safe-state
    trap lands on GOLDEN - a mangled loader fails toward the mask ROM,
    never toward silence.
    The suite proves the architecture's load-bearing claims against the
    real five-macro SECDED SRAM: a bank's valid flag flips only after the
    STORED image's read-ba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
2026-08-13 Register brief v2: MRAM in the package, the test ladder, repo hygiene
    The program register absorbs the second briefing pass verbatim. A5
    grows from an updatability story into a persistent-memory
    architecture: SiP/MCM with a space-grade MRAM die (minimum 2x16 Mb,
    recommended 2x64-128 Mb - firmware A/B banks plus data space in one
    NVM the competition leaves outside the package), QSPI controller
    with TMR on the chip side, and SRAM capacity targets per chip
    generation. Two new workstreams: G, the test ladder from cheap to
    expensive - pre-silicon coverage and X-prop, bench shmoo and soak,
    glitch injection, laser TPA, protons-first beam ordering with the
    statistics designed up front, TID/SEL as th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
2026-08-13 Build the debug isolation gate and register the DFT plan
    docs/DEBUG-DFT.md sets F27/F28: the riscv-dbg + JTAG integration
    plan with the two requirements the rad-hard context adds - a flight
    lock with no software unlock, and an isolation boundary that treats
    the debug module as untrusted logic - plus the DFT ladder: scan with
    voter-bypass and a tmr-guard scan check, a march engine over the
    SRAM macros' shipped BIST ports that serves production screening,
    commanded flight self-test and the SRAM beam experiment at once,
    IDDQ and screening modes, boundary scan.
    zirh_dbg_gate is the piece worth silicon today: the strap latches
    once at reset release and then the pin is dead in both directions;
    ev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
2026-08-13 Stand up the CI line: lint, every unit suite, tmr-guard, badges
    H41 called the missing CI line the biggest gap, and the new lint
    gate proved the point before it was even committed: its first local
    pass caught a real mixed blocking/nonblocking assignment on the
    SpaceWire encoder's parity register - legal in the event scheduler
    that verified the chip, undefined across tools - now fixed with
    byte-identical semantics and the full RTL suite green on top.
    ci.yaml runs on every push what previously ran only on one bench:
    the verilator gate over the ZIRH-authored RTL with few, individually
    justified waivers and LATCH/WIDTHTRUNC/BLKANDNBLK armed; the six
    unit suites - housekeeping, the SECDED SRAM w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
    [zirh_env.v, zirh_spw.v]
2026-08-13 Traceability as code and the repro handle
    H49 and H43 are the same promise from two sides: every claim has a
    test, and every test replays. requirements.yaml maps nineteen
    requirements onto thirty-eight test files and the CI jobs where their
    evidence runs - the escape-window theorem, the SECDED contract and
    its address mask, the scrubber, the no-brick boot ladder, the debug
    lock, the BIST discipline, the TMR synthesis guard, the campaign
    contract, the interface protocols, the per-block unit contracts and
    the frozen pre-beam prediction. scripts/trace_check.py enforces the
    chain on every push: a requirement referencing a missing test fails
    the build, and a test module no requirement claims is r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
2026-08-13 Freeze the beam analysis and codify the waveform policy
    H48 first: scripts/beam_analysis.py is the registered analysis,
    frozen before any beam exposure and tested in CI against synthetic
    truth on every push. Exact Poisson rate-ratio inference for
    ESC(B)/ESC(A) with fluence normalization and a conditional binomial
    test - the G37 statistics design executed in code; the TT-harness
    confound subtraction with propagated uncertainty, so a harness SEFI
    cannot masquerade as a tile event (G36); and a Weibull
    cross-section-vs-LET fit by coarse-to-fine search, standard library
    only, because in a frozen script reproducibility beats elegance. The
    selftest demands the elevated case flags, the identical cas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
2026-08-13 The register map becomes data, the bench becomes code
    H47: regmap.yaml is the single machine-readable source, transcribed
    from the RTL decode blocks - every register with its fields, one-shot
    semantics and reset notes. The generator emits docs/REGMAP.md and
    fw/zirh_regs.h, and the CI sync gate regenerates and diffs on every
    push so the YAML, the documentation and the header cannot drift
    silently; the hand-written firmware header is cross-checked address
    by address and agreed on all thirteen, which is the outcome you want
    from a gate: it found nothing, and now nothing can appear.
    H45: host/zirh_bench.py is the bring-up ladder as code. Smoke gives
    the five-minute is-it-alive verdict with an e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
    [regmap.yaml, zirh_bench.py, zirh_regs.h]
2026-08-13 Finish the campaign paperwork before the application asks for it
    docs/BEAM-PLAN.md is B7, G34, G36, G37 and G38 in one place, done to
    the brief's own rule that campaign design precedes the facility
    application. Protons first with the Ankara TAEK/SANAEM line flagged
    as the local option; neutron statistics; heavy ions with
    decapsulation and spare DUTs budgeted. The statistics come first:
    thirty to fifty events per chain, flux capped at one event per
    readout window so the burst correlator can tell pile-up from
    physics, and the live console re-planning the shift from the first
    measured hour. The TT-harness confound gets its registered protocol:
    a deselected-tile control run per session, written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
2026-08-13 Build the QSPI-MRAM controller; the A5 chain closes in simulation
    The chip-side leg of the persistent-memory architecture. SPI mode 0
    master with standard READ on one lane and quad-output READ with
    dummy cycles on four; command and address always on IO0; the byte
    stream lands directly on the boot controller's transport-agnostic
    port, which is exactly why that port was transport-agnostic. Flow
    control belongs to the consumer: a stall freezes SCK with CS held
    and the transfer resumes bit-exact - proven under seventy percent
    random backpressure. Abort and the TMR safe-state trap both release
    the bus immediately, because a mangled controller must let go of
    the MRAM, never hold it hostage. State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
2026-08-13 Specify the DUT board: testable before it exists, safe when it does
    The last engineering box on the beam checklist. Every requirement
    cites the campaign document that demanded it: per-rail current
    monitoring fast enough to reconstruct the SEL signature, an
    autonomous comparator trip into a p-FET switch under ten
    microseconds - because a latched DUT cooking during a network hiccup
    is how campaigns lose their silicon - and thresholds derived from
    the measured bench baseline, never guessed at the facility. The
    telemetry mirror gets its own RS-422 driver, its own cable and its
    own adapter, sharing nothing with the primary voice it exists to
    outlive. The mechanics center the tile in a marked wind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
2026-08-13 Productize tmr-guard: the demo that sells itself
    E19 at its smallest-effort-first-revenue shape. The tool gets its
    own home with a vendor-neutral thirty-line demo - a voted register
    pair whose hardening the optimizer will delete the moment the
    attribute is gone - and the demo's manifest numbers were measured,
    not declared, which is the tool's own philosophy applied to itself.
    The negative control is the pitch: one command passes, the next
    strips the protection attributes from a copy and proves the checker
    catches exactly the collapse it exists for. A checker that cannot
    fail is worse than no checker, and this one demonstrates its teeth
    on every push, because both the demo and ZIRH-2's own te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
    [demo_design.v]
2026-08-13 Build the corner-timing flow and settle the SDF support question
    G30's simulation half. The shipped netlist runs with the hardening
    run's own SDF at the three characterized corners - both
    military-range extremes among them - through a plusarg shim that
    annotates tb.user_project and touches nothing else, and the
    X-propagation monitor rides in the same test: after boot, an
    unknown reaching any output pin fails the run.
    The support question got the treatment every silent tool deserves: a
    two-gate micro-experiment with a delay large enough to see. It
    caught the trap - the TT iverilog's sdf_annotate returns success and
    silently ignores min::max pairs that lack a typical value, applying
    only full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
    [Makefile.sdf]
2026-08-13 Lay the software ecosystem's first stone: the map-true HAL
    F29 begins where the competition's real value lives. fw/hal/ is the
    driver layer - UART, watchdog signon, the full EDAC counter block,
    one-shot fault injection, the TID and SET instruments, CAN and
    SpaceWire - written as static inline functions over the GENERATED
    register header, which means the HAL cannot drift from the RTL
    without the regmap sync gate failing the build first. The example
    application is the canonical flight-shaped main loop: sign on every
    iteration, read the counters, make an uncorrectable loud instead of
    hiding it, answer the ground with the echo contract. It compiles to
    244 bytes at -Wall -Werror with no libc, and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
    [example_app.c, zirh_hal.h]
2026-08-13 Claim the corner-timing suite in the traceability map (R28)
    The sdf test rode in with Cycle 26 unclaimed; the map now owns it:
    boot at spec clock under annotated corner delays with the X monitor
    armed, evidenced by the dispatch matrix and the recorded
    micro-experiment that settled the annotator's honesty.
2026-08-13 Three studies land: the core, the silicon path, the control lines
    C12: the product-core selection study with hard criteria - flow
    compatibility without sv2v adventures, TMR-ability of the state,
    verification carry-over, then performance - and a recommendation:
    Hazard3 primary on its clean-Verilog flow fit and mass-silicon
    heritage, picorv32 as the conservative fallback that buys the
    methodology story if instrumentation surprises, Ibex watched for
    its DV culture. Numbers get re-measured on our flow before any
    commitment; the study exists so the decision is a day, not a month.
    C14: the dedicated-silicon cost ladder, with a researched surprise
    on rung two: IHP grants ~2 mm2 of FREE SG13G2 sili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
2026-08-13 Plan the cheap rungs: glitch injection and laser TPA
    G32 and G33 - the test-ladder rungs that validate the recovery
    machine and image the placement hypothesis before beam money. The
    glitch plan fires the watchdog, the safe-state traps and the
    clock-loss observer on real silicon with a ChipWhisperer-class rig
    tapping the DUT board's already-isolated clock and core rail, and
    confirms the GL campaign's SURVIVED/REBOOTED/ZOMBIE taxonomy
    reproduces on hardware - reusing host/zirh_campaign.py unchanged,
    because the classifier does not care what caused the upset. The TPA
    plan images the placement-A/B prediction directly: raster chain B's
    3.78 um pairs to find the same-bit-same-cycle escape physical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
2026-08-13 Position on checkable truth, not price (E24)
    The brief's strategic instruction made concrete. A 130 nm ~1 MIPS
    part cannot win a price war and should not try; it wins on the one
    thing no incumbent offers and this repository already contains -
    every protection claim carrying its formal proof, its gate-level
    campaign and its registered prediction in the open, auditable by
    anyone. Radical transparency is the moat a newcomer can build that
    the incumbents cannot copy without dismantling their own secrecy.
    The document names who this wins (the COTS+ buyer burned by an
    unverifiable datasheet, the reviewer who must be shown) and who it
    does not (the QML-heritage prime), because naming that boundary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
2026-08-13 Complete the bench ladder: the shmoo plan and the G31 procedure
    host/shmoo_plan.csv is the default operating-envelope grid the
    bench shmoo consumes - a nominal-voltage frequency walk, a voltage
    margin sweep, and the STA/SDF-characterized corners as the last
    rows so silicon that passes them confirms the timing sign-off the
    corner sims proved. docs/BENCH-PROCEDURE.md is the G31 ladder from
    cold board to certified false-positive floor: current baseline
    feeding the SEL threshold, smoke go/no-go, block-by-block
    functional, the shmoo, the temperature sweep, and the soak whose
    zero-event floor is the certificate every beam counter stands on.
    Every step maps to a tool already tested against the simu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
    [shmoo_plan.csv]
2026-08-13 Scope ZIRH-3: design-ready blocks, gated by data not readiness
    Every piece a dedicated rad-tolerant SoC needs now exists in
    simulation - SECDED SRAM with slicing and scrubbing, the QSPI-MRAM
    boot path, the debug isolation gate, the BIST engine, the clock-loss
    observer. This document integrates them into one die AND gates that
    die: ZIRH-3 starts not because the blocks are ready but when
    ZIRH-1/2 beam data closes the open decision gates, because a
    dedicated die baking in an unverified placement-A/B assumption would
    be the one time the program believed before it measured. The free
    IHP OpenMPW slot is the vehicle, so the rehearsal waits behind the
    data gate and not the money one. The honest new-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
2026-08-13 Close the engineering register: the program status ledger
    Every autonomous item in the obstacle register is now done and the
    ledger names the artifact that closed each one - memory foundation,
    boot and update, campaign engineering, the core and cost studies,
    traceability with its ECSS rendering, the commercial assets, debug
    and DFT, the full test ladder and the ten-item hygiene sprint. What
    remains open is exactly the GATE list: shuttle submission, beam
    money, MPW money (possibly zero, per the cost study), pilot
    customer, review partner, flight. The register now reads as what it
    is - an engineering program complete to the edge of decisions that
    belong to its owner.
2026-08-13 Close Cycle 26: three corners green, zero pin X at real delays
    All three characterized corners ran the shipped netlist to
    completion at its own SDF delays: the binding setup corner at 1.08 V
    and 125 C, typical, and the hold-risk extreme at 1.32 V and -40 C.
    Every corner boots, produces a valid telemetry frame from a living
    CPU, and finishes with zero unknowns reaching any output pin after
    the monitor arms. The pre-silicon timing gap G30 named is closed -
    the netlist keeps its word across the full military range in both
    directions, and the X-propagation monitor confirms what a pure STA
    report cannot: no un-initialized state ever leaks to a pin. The
    matrix stays repeatable against any future h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
2026-08-13 Drain the figure queue the waveform policy promised
    The completeness audit's one thin spot, closed with real renders.
    The SEU-heal figure shows the whole TMR story in one window:
    replica A takes the hit, B and C stay clean, the voted output never
    moves, the mismatch detector pulses, and the chip's output pins
    keep their rhythm - the computer never notices. The uncorrectable
    figure shows the double-bit moment: nonzero syndrome, the uncorr
    flag, the event pulse, the scrubber walking on. Both are rendered
    from the suites' own dumps through committed gtkw layouts, so any
    reader can regenerate them from a WAVES=1 run. The tmr-guard figure
    is the sales pitch as a diagram: the same netlist before a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
2026-08-14 Draw the instance-level block diagram
    The README's ASCII sketch stays as the quick orientation; the new
    SVG is the detailed map - every RTL instance from u_clk_rst through
    the SoC's CPU/ROM/bus/ECC-RAM/UART, the three monitor rings with the
    placement experiment's numbers, the housekeeping islands and
    watchdog, the environment instruments, both telemetry voices and
    both interface experiments, wired to the full pin map with event
    paths marked. One figure a reviewer can hold next to the source tree
    and find every box by name.
2026-08-14 Redraw the block diagram for the eye
    Same instance-level truth, presentable form: color-coded groups
    (computer, monitor, environment, telemetry, interfaces), rounded
    cards, pin pills on both rails colored by domain, orthogonal wires
    with arrowheads and the event paths dashed red - rendered and
    inspected before committing, twice, because a diagram nobody wants
    to look at documents nothing.
2026-08-14 Straighten the diagram's wires
    Every net now runs orthogonally through a clear lane: liveness and
    event pins exit the group TOPS into the lane above the boxes, the
    ECC and bus-timeout events dive down the column gaps and travel
    under the groups to the right rail, the environment feed drops
    straight into telemetry, UART_TX climbs the tlm/mirror gap, and the
    SpaceWire pins hang directly under their own block instead of the
    CAN box. No wire crosses through a box anymore - rendered and
    inspected.
2026-08-14 Give the chip a programming interface: the ISP goes on-die
    The owner asked for a way to write any program into the chip, and
    physics set the terms: SG13G2 carries no flash module (floating
    gates are the worst radiation choice anyway), and the pin budget
    leaves one spare bidirectional pin - not a QSPI. So the flash stays
    on the host side and the die gets the F25 boot controller in its
    UART-host configuration. ui[2] high at power-up straps the loader:
    a MAGIC/len/version/CRC32 image streams in at the reset baud through
    the loader's own receiver while the whole SoC is held in reset, the
    STORED words are re-read and CRC'd, and only a verified bank
    releases the CPU - whose fetch path now muxes be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
    [test_isp.py, tt_um_hma_zirh2.v, zirh_scenarios_tb.sv]
2026-08-14 Fit the loader to the die: PROTECT=0 and the placement verdict
    The hardening run answered fast and clearly: detailed placement
    failed at CTS - the TMR'd loader's 540 extra flops did not fit the
    16.7% of die the experiment left free. The fix respects both truths
    at once. zirh_boot_ctrl gains a PROTECT parameter through a local
    zirh_boot_reg primitive whose generate scope lives INSIDE the
    loader, so no hierarchical path anywhere else moves - the flip
    suites and force-based campaigns keep their footing. ZIRH-2
    instantiates PROTECT=0: one plain register per field, 197 extra
    flops instead of 540, defensible because every confusion mode of
    this FSM already falls to the mask ROM through the case-de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
    [tb_torture.v, tt_um_hma_zirh2.v]
2026-08-14 Ask the hold resizer for a fifth of the cushion
    Two identical DPL-0036 failures at ResizerTimingPostGRT with the
    same homeless set proved the wall is local room for hold buffers,
    not the global density target: 132 buffers repaired toward a 60 ps
    cushion and 42 of them found no legal row. 0.02 repairs toward
    20 ps - fewer, smaller insertions in the same packed neighborhoods -
    and hold correctness stays gated where it always was, at signoff STA
    and the three-corner SDF boot simulations.
2026-08-14 Restore the proven recipe; give hold buffers reach instead
    Knob-sweep post-mortem, recorded in the config where the campaign
    keeps its lessons: density 79->82 left the homeless set identical,
    and hold margin 0.06->0.02 exploded insertions from 132 to 2431 -
    at this fullness the routed-parasitic repair is a lottery and
    neither knob connects to the wall. Both return to their proven
    values. The one knob aligned with the actual failure is reach: the
    homeless cells are hold buffers, a hold buffer pushed far GAINS
    delay - which is its purpose - so PL_MAX_DISPLACEMENT_Y rises to
    400 and the legalizer may carry them across the full die height.
2026-08-14 Second diet round: the glue borrows what already exists
    The housekeeping block already pulses cpu_alive on every CPU_SIG
    write, so sign-on detection drops its shadow register and costs
    zero new state; the watchdog grace age counts tick256 pulses the
    clock block already makes instead of raw cycles - same wall-clock
    grace, eight fewer flops, and the tick finally earns its keep. The
    first diet measurably moved the wall (132 hold buffers down to 95,
    homeless from 42 to 22), so this round pushes the same direction:
    measured top now 3864 flops, replicas unchanged at 49, ISP suite
    and lint green.
2026-08-14 Relax the fanout rule the die cannot afford
    Round-six census settled the hold story - 132, 95, then 21 buffers
    as the loader diets landed - and exposed the real crowd: post-GRT
    repair_design inserting 2002 buffers for 401 max-fanout violations,
    the reset cone re-buffered after the ISP hold gate joined it. At
    20 MHz with +22 ns of setup slack a fanout-10 rule buys nothing this
    design needs; 16 halves the buffer bill, slew repair still guards
    the transition edges, and the freed sites are exactly the room the
    last few dozen homeless cells have been asking for.
2026-08-14 State the fanout rule where the tools actually read it
    Two identical runs - 401 violations, 2002 buffers, to the cell -
    proved MAX_FANOUT_CONSTRAINT was a wheel connected to nothing, and
    the log said why on every run: PNR_SDC_FILE undefined, generic
    fallback in use. The explicit pnr.sdc is the same constraint set
    with fanout 16 stated in the file the construction steps consume;
    signoff STA keeps its own SDC, so the verdict stays as strict as it
    ever was.
2026-08-14 Speak the baud override where iverilog can hear it
    The scenario suite's sixty silent CI minutes had one more layer:
    iverilog's -P reaches only root-scope modules, and this bench IS the
    root, so the RESET_DIV override on the DUT was silently ignored and
    the chip kept talking at 174 - the night's fourth silently-eaten
    knob, and the same lesson each time: a tool that returns success is
    not a tool that did the work. The divisor now lives on the DUT
    instantiation itself, where no scope rule can eat it, and the boot
    wait returns to twice nominal to match the cocotb integration suite
    - the bit-serial CPU needs the second window to reach its command
    loop before a scenario talks. Four scenarios re-va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
    [zirh_scenarios_tb.sv]
2026-08-14 Make the scenario suite actually run all seventeen
    The chip-level SV suite had never completed - the CI timeout hid five
    test-authoring bugs behind the first hang, each now found with a probe
    and fixed, none of them in the RTL:
    - cpu_alive read the signature at frame byte 16 (the BOOT count, which
    is legitimately zero) instead of 15
    - echo_sweep expected 0x33 to echo, but 0x33 is '3', a real inject
    command, not an echoed byte - replaced with 0x35, just above the
    command block
    - inject_counters sent two commands back to back; the bit-serial CPU
    has a single RX register and no FIFO, so the first was clobbered
    before firmware read it - a frame-time gap fixes it and documents
    the co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
    [zirh_scenarios_tb.sv]
2026-08-15 Revive the standalone SoC suite and put it where rot is visible
    The zirh3 import surfaced it: this suite had been failing since the
    ISP ports landed on zirh_soc - undriven new inputs flooded the design
    with X - and nobody noticed because Makefile.soc was never in CI. The
    suite now drives the loader port explicitly (with por_rst_n_i pulsing
    as the real POR it is), passes 3/3 again, and joins the CI units job
    so it cannot rot silently a second time. The night's refrain once
    more: a suite that is not run is a suite that is broken.
    [test_soc.py]
